tobsec/rusefi-hardware/lambda-x2/export/rev2/lambda-x2-rev2.pdf

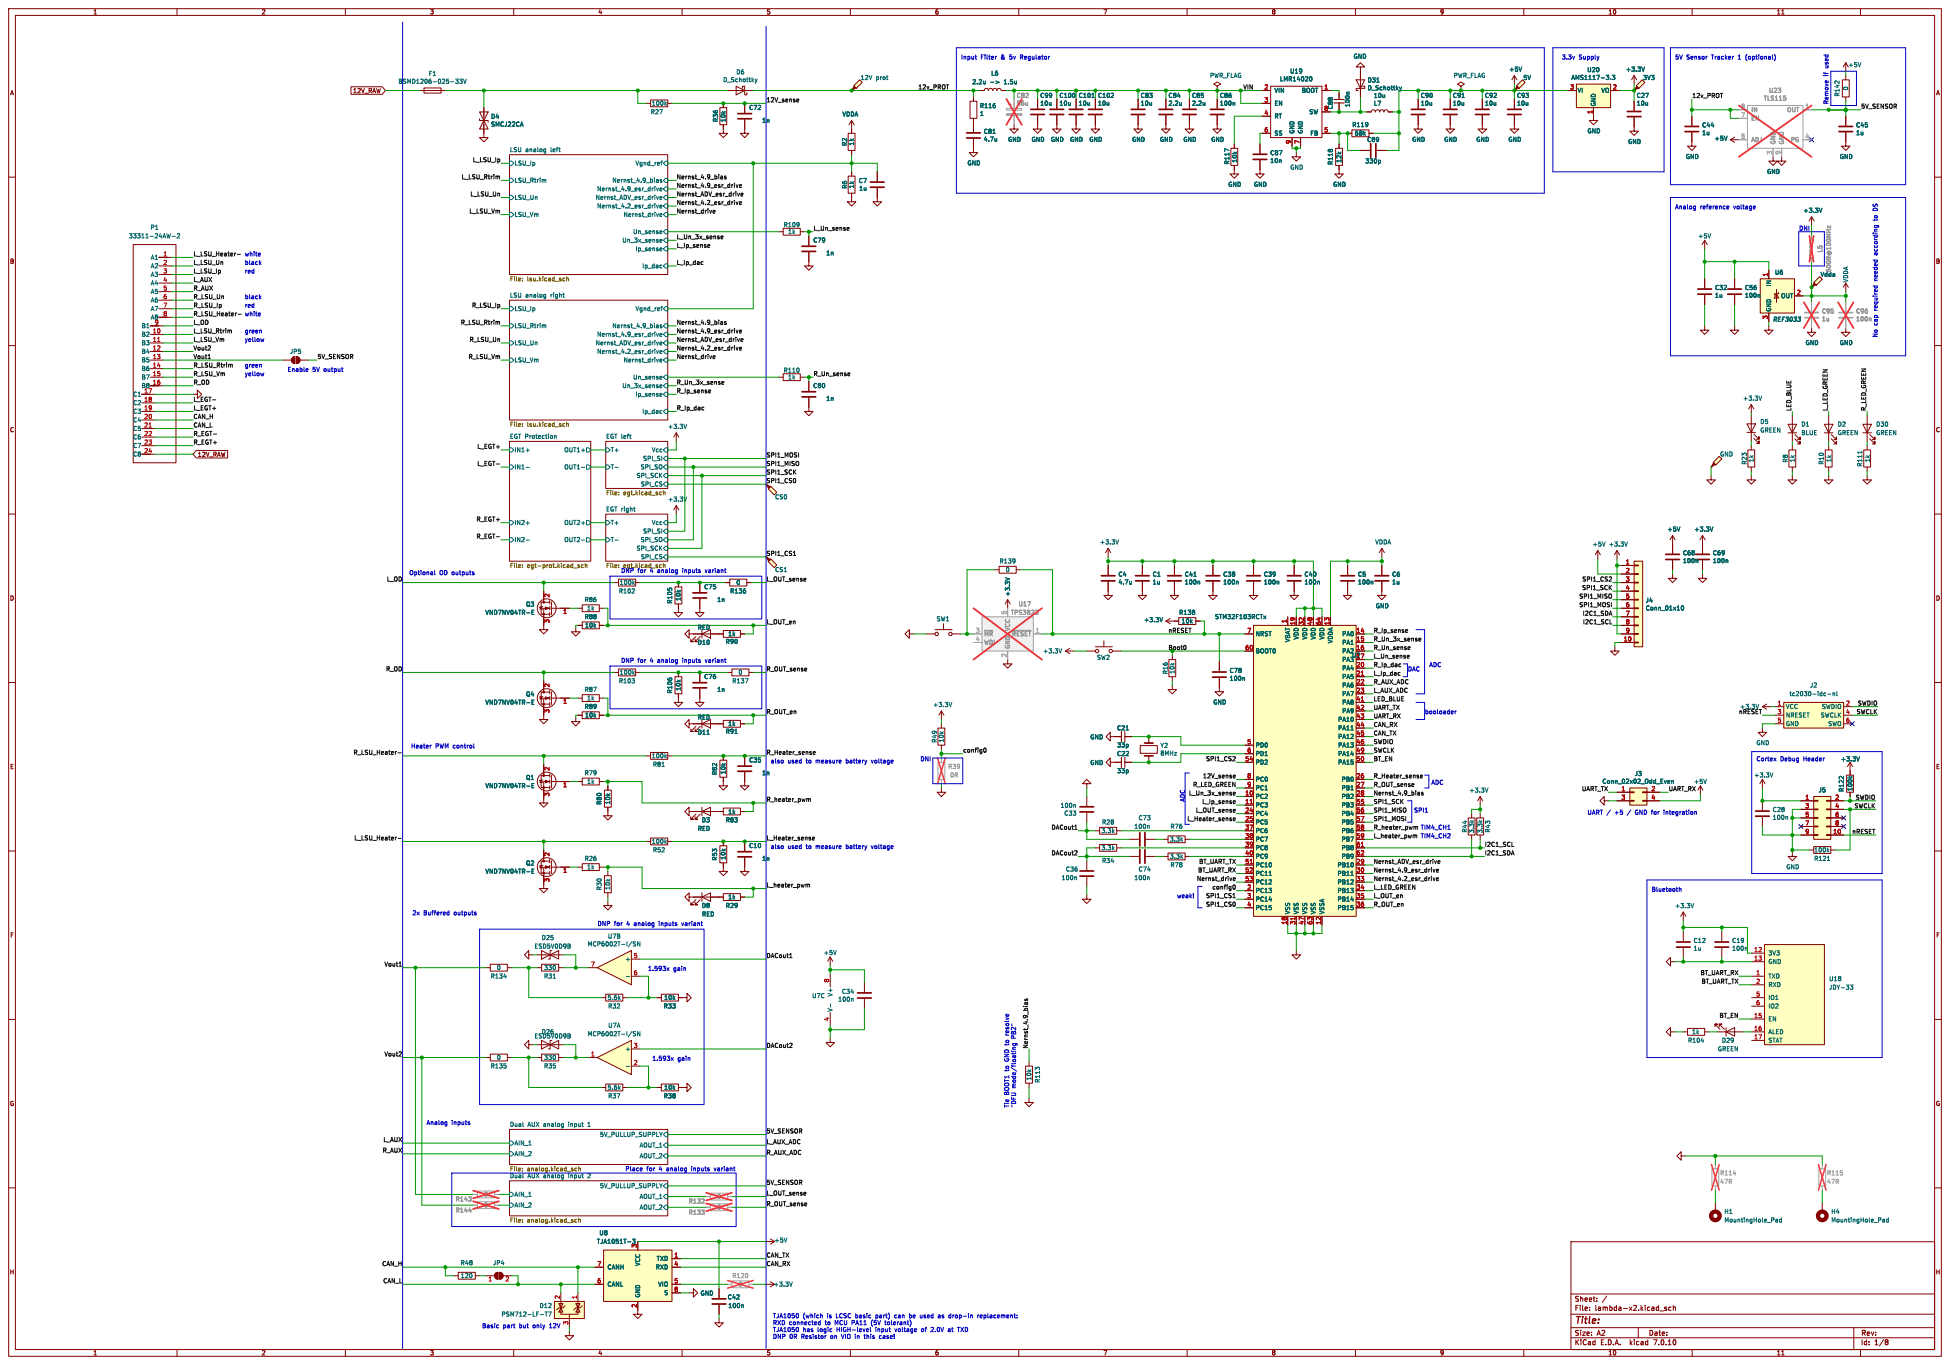
[picture p1: page 1]

LSU analog left File: lsu.kicad_sch

L_LSU_Vm
LSU analog right File: lsu.kicad_sch

SPI_CS
DNP for 4 analog inputs variant

DNP for 4 analog inputs variant Basic part but only 12V

5V_PULLUP_SUPPLY Dual AUX analog input 1 File: analog.kicad_sch

Place for 4 analog inputs variant

5V_PULLUP_SUPPLY Dual AUX analog input 2 File: analog.kicad_sch

3 RXD 4 VIO 5 CANL 6 CANH 7 S

DNP 0R Resistor on VIO in this case!

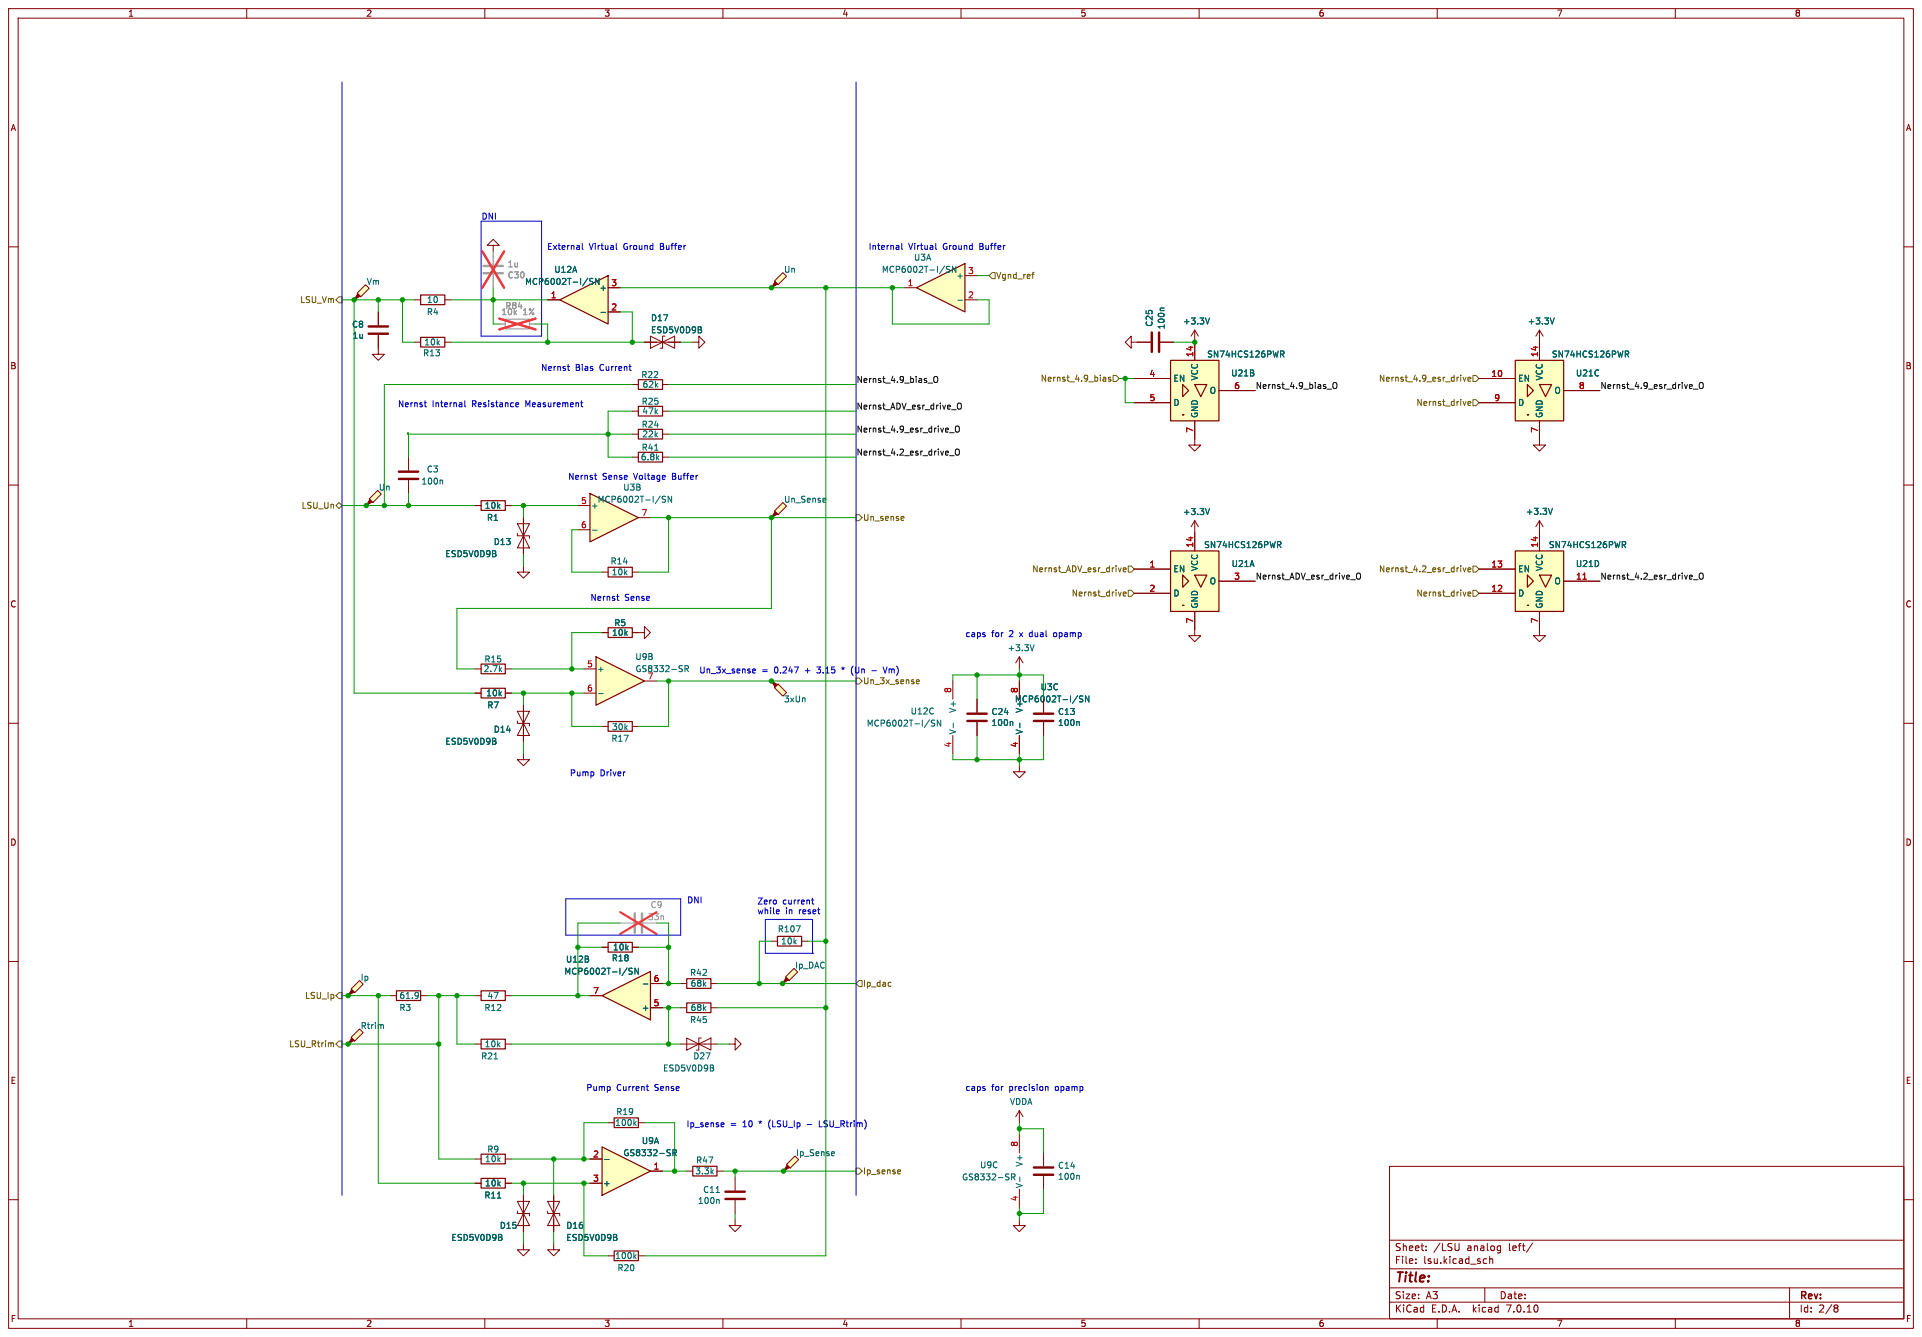
[picture p2: page 2]

Zero current while in reset

Id: 2/8 Title: File: lsu.kicad_sch Sheet: /LSU analog left/

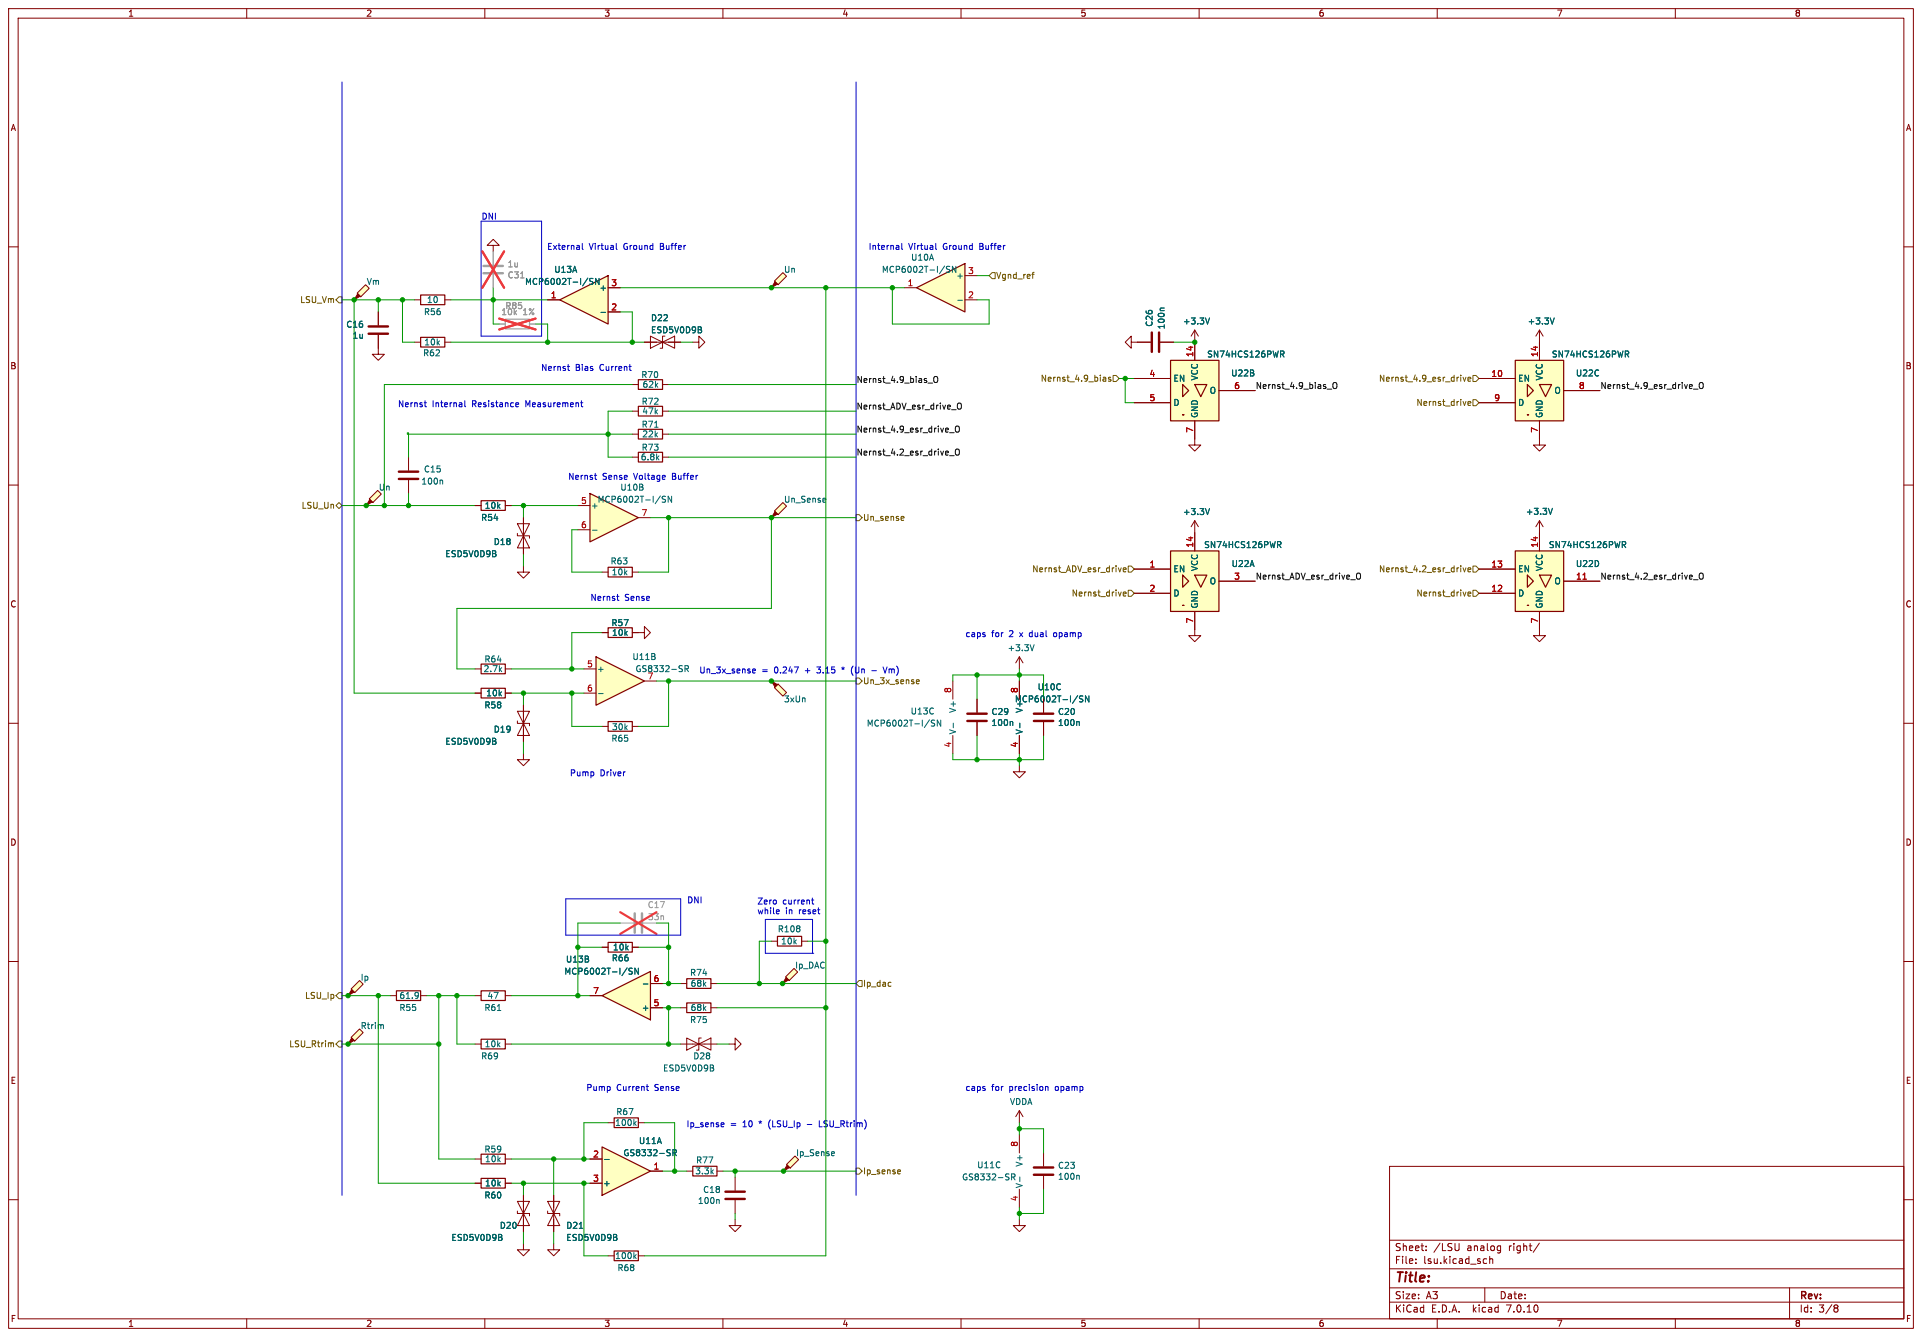
[picture p3: page 3]

Zero current while in reset

Id: 3/8 Title: File: lsu.kicad_sch Sheet: /LSU analog right/

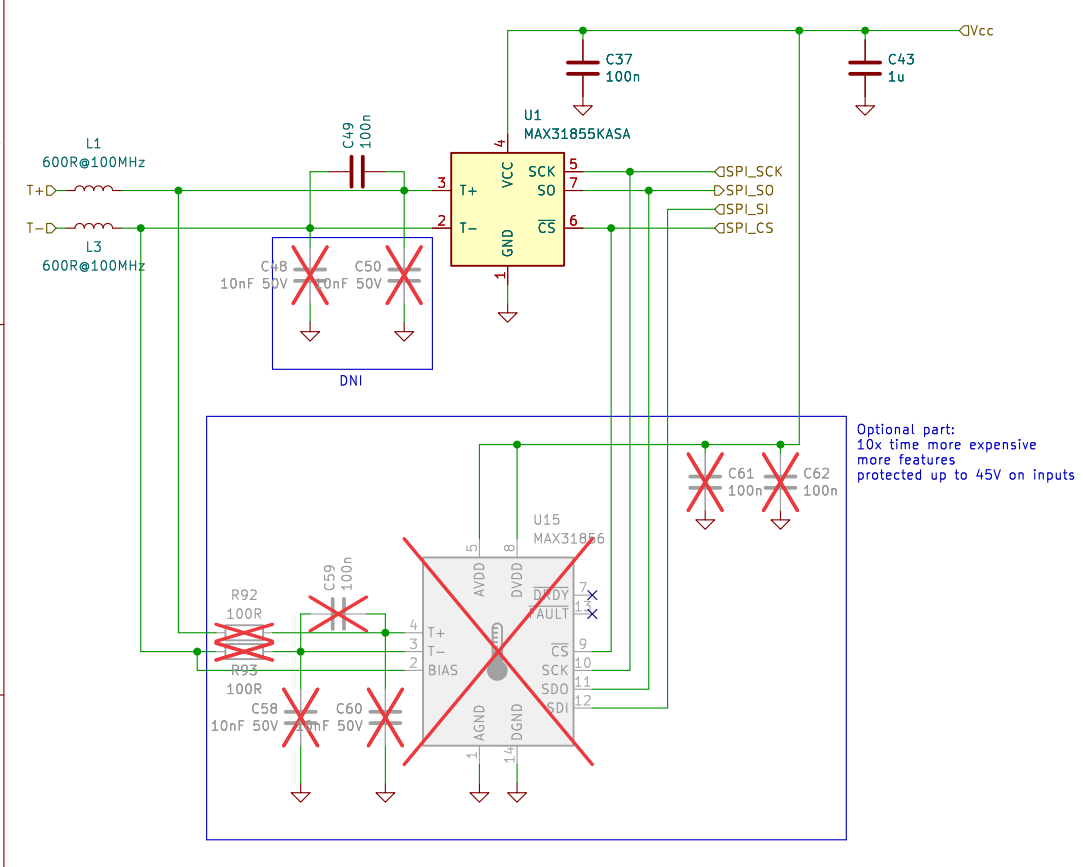
[picture p4: page 4]

1 SCK 10 SDO 11 SDI 12 ~{FAULT} 13 DGND 14 BIAS 2 T- 3 T+ 4 AVDD

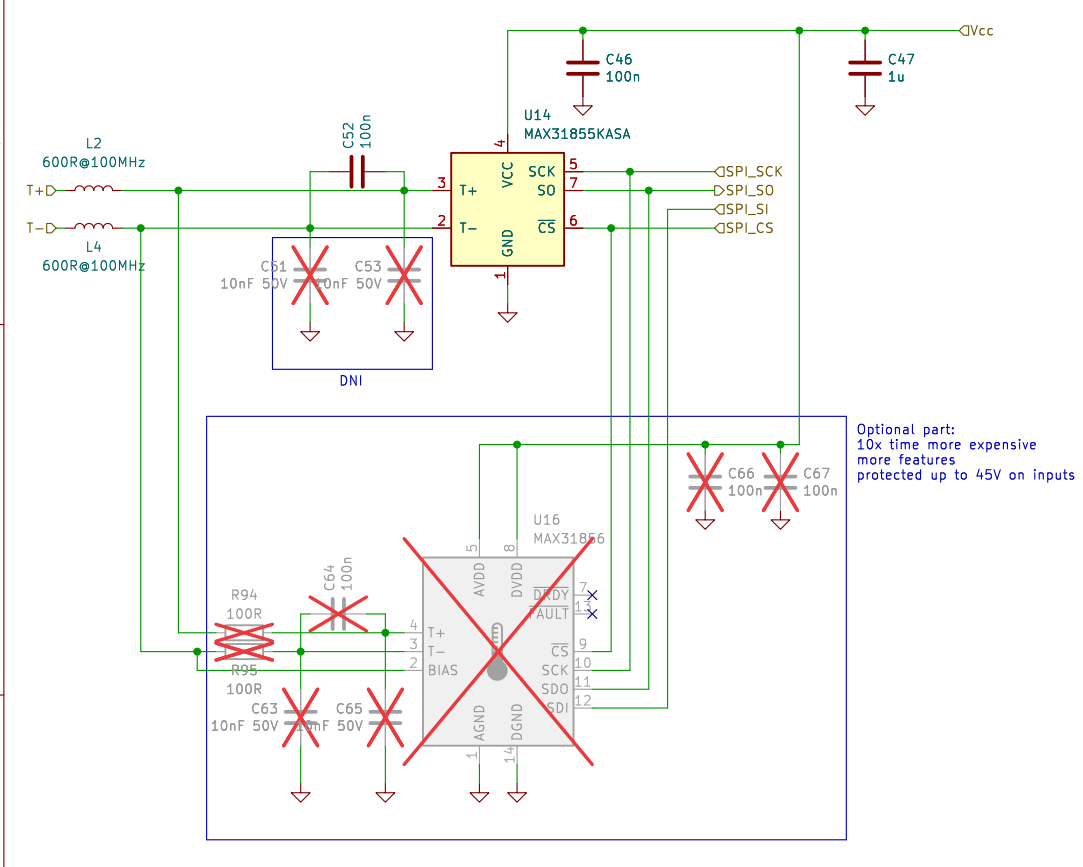
[picture p5: page 5]
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

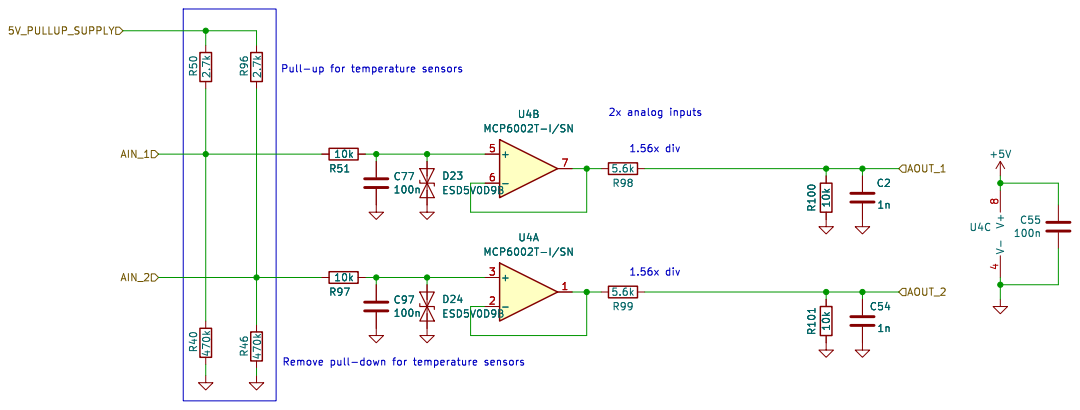
[picture p6: page 6]

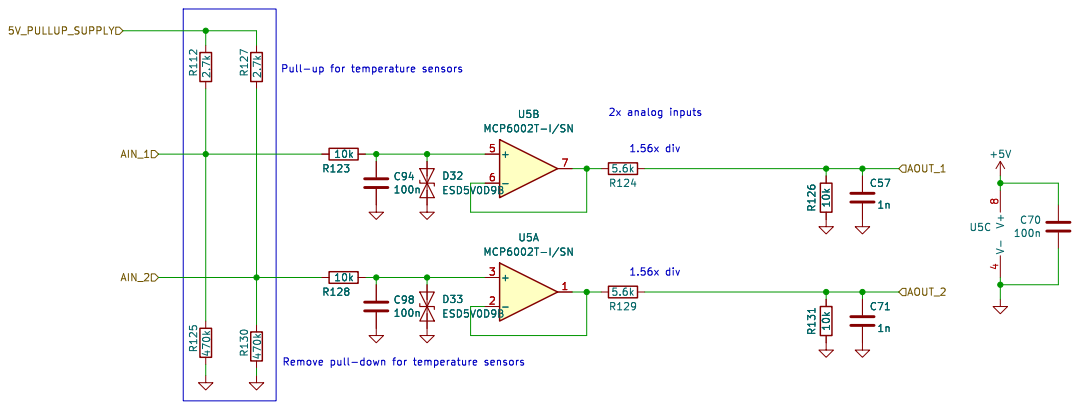
[picture p7: page 7]

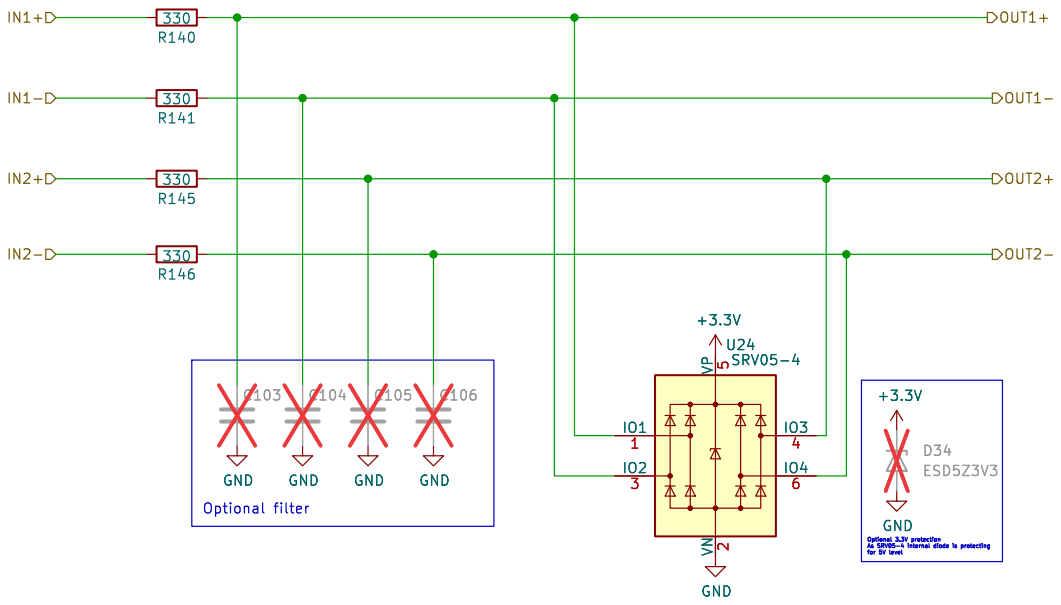
[picture p8: page 8]
