tobsec/rusefi-hardware/lambda-x2/analog.kicad_sch

## KiCad design lambda-x2/analog.kicad_sch (2024-02-21)

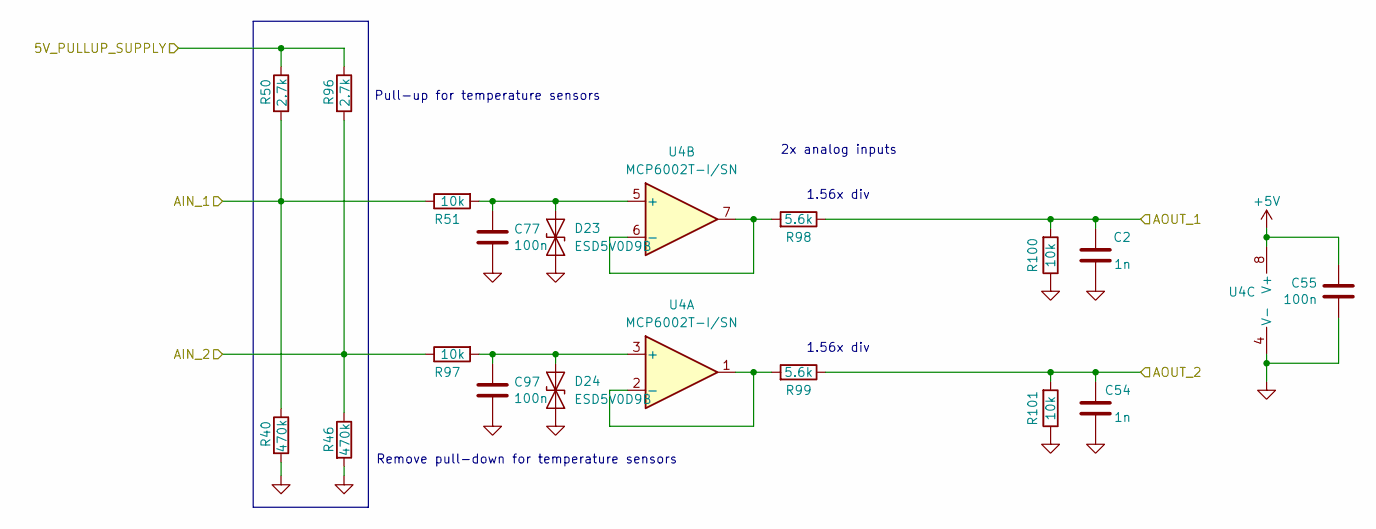
[picture p9: schematic analog.kicad_sch]

Parts:
C2, C54: 1n; C_0402_1005Metric; LCSC C1523
C55, C77, C97: 100n; C_0402_1005Metric; LCSC C1525
D23, D24: ESD5V0D9B; D_SOD-923; LCSC C484329
R40, R46: 470k; R_0402_1005Metric; LCSC C25790
R50, R96: 2.7k; R_0603_1608Metric; LCSC C13167
R51, R97, R100, R101: 10k; R_0402_1005Metric; LCSC C25744
R98, R99: 5.6k; R_0402_1005Metric; LCSC C25908
U4: MCP6002T-I/SN; SOIC-8_3.9x4.9mm_P1.27mm; LCSC C7377

Connections:
5V_PULLUP_SUPPLY: R50.1, R96.1
+5V: C55.1, U4.8 (V+)
AIN_1: R40.1, R50.2, R51.1
AIN_2: R46.1, R96.2, R97.1
AOUT_1: C2.1, R98.1, R100.2
AOUT_2: C54.1, R99.1, R101.2
GND: C2.2, C54.2, C55.2, R40.2, R46.2, R100.1, R101.1, U4.4 (V-)
unnamed: C77.1, D23.1 (A1), R51.2, U4.5 (+)
unnamed: C97.1, D24.1 (A1), R97.2, U4.3 (+)
unnamed: R98.2, U4.6 (-), U4.7
unnamed: R99.2, U4.1, U4.2 (-)
~: C77.2, C97.2, D23.2 (A2), D24.2 (A2)

Notes on the sheet:
Remove pull-down for temperature sensors
2x analog inputs
1.56x div
Pull-up for temperature sensors
