tobsec/rusefi-hardware/lambda-x2/egt-prot.kicad_sch

## KiCad design lambda-x2/egt-prot.kicad_sch (2024-02-21)

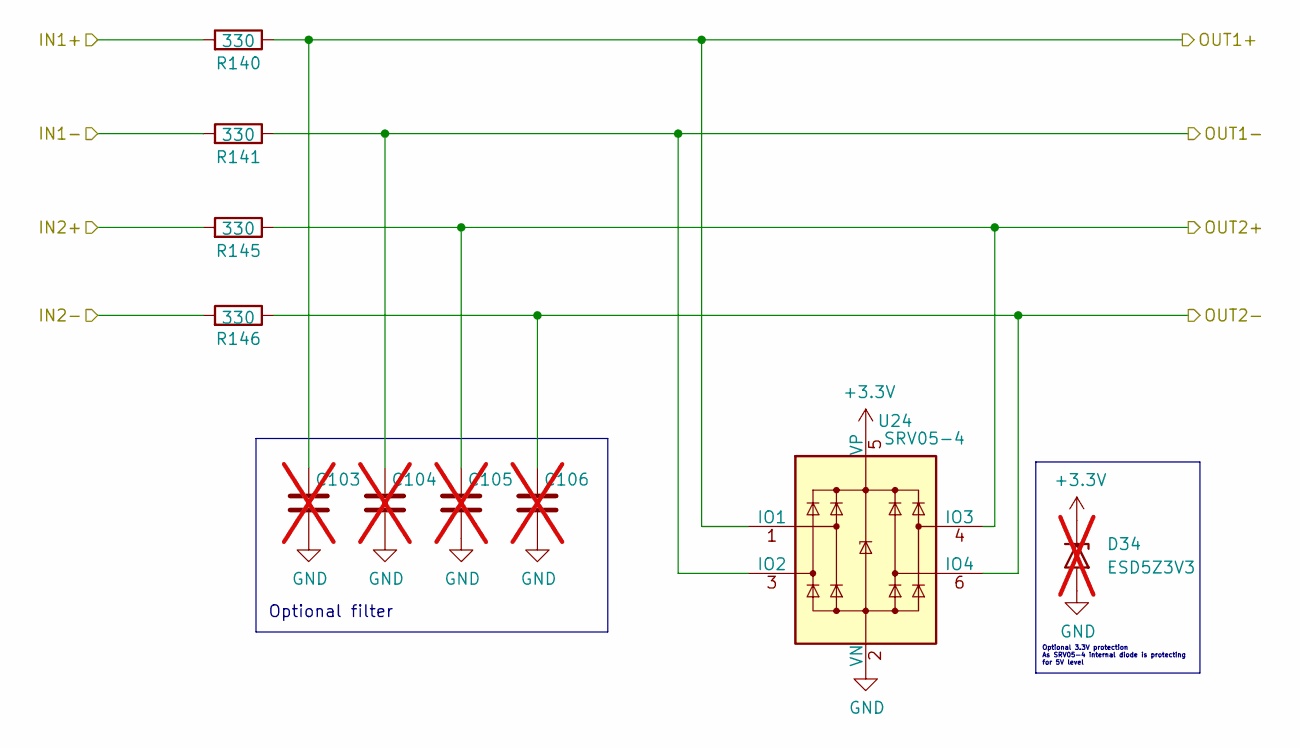
[picture p10: schematic egt-prot.kicad_sch]

Parts:
C103, C104, C105, C106: C_0402_1005Metric; not fitted
D34: ESD5Z3V3; D_SOD-523; LCSC C502545; not fitted
R140, R141, R145, R146: 330; R_0603_1608Metric; LCSC C23138
U24: SRV05-4; SOT-23-6; LCSC C85364

Connections:
+3.3V: D34.1 (A1), U24.5 (VP)
GND: C103.2, C104.2, C105.2, C106.2, D34.2 (A2), U24.2 (VN)
IN1+: R140.2
IN1-: R141.2
IN2+: R145.2
IN2-: R146.2
OUT1+: C103.1, R140.1, U24.1 (IO1)
OUT1-: C104.1, R141.1, U24.3 (IO2)
OUT2+: C105.1, R145.1, U24.4 (IO3)
OUT2-: C106.1, R146.1, U24.6 (IO4)

Notes on the sheet:
Optional 3.3V protection As SRV05-4 internal diode is protecting for 5V level
Optional filter
