tobsec/rusefi-hardware/lambda-x2/egt.kicad_sch

## KiCad design lambda-x2/egt.kicad_sch (2024-02-21)

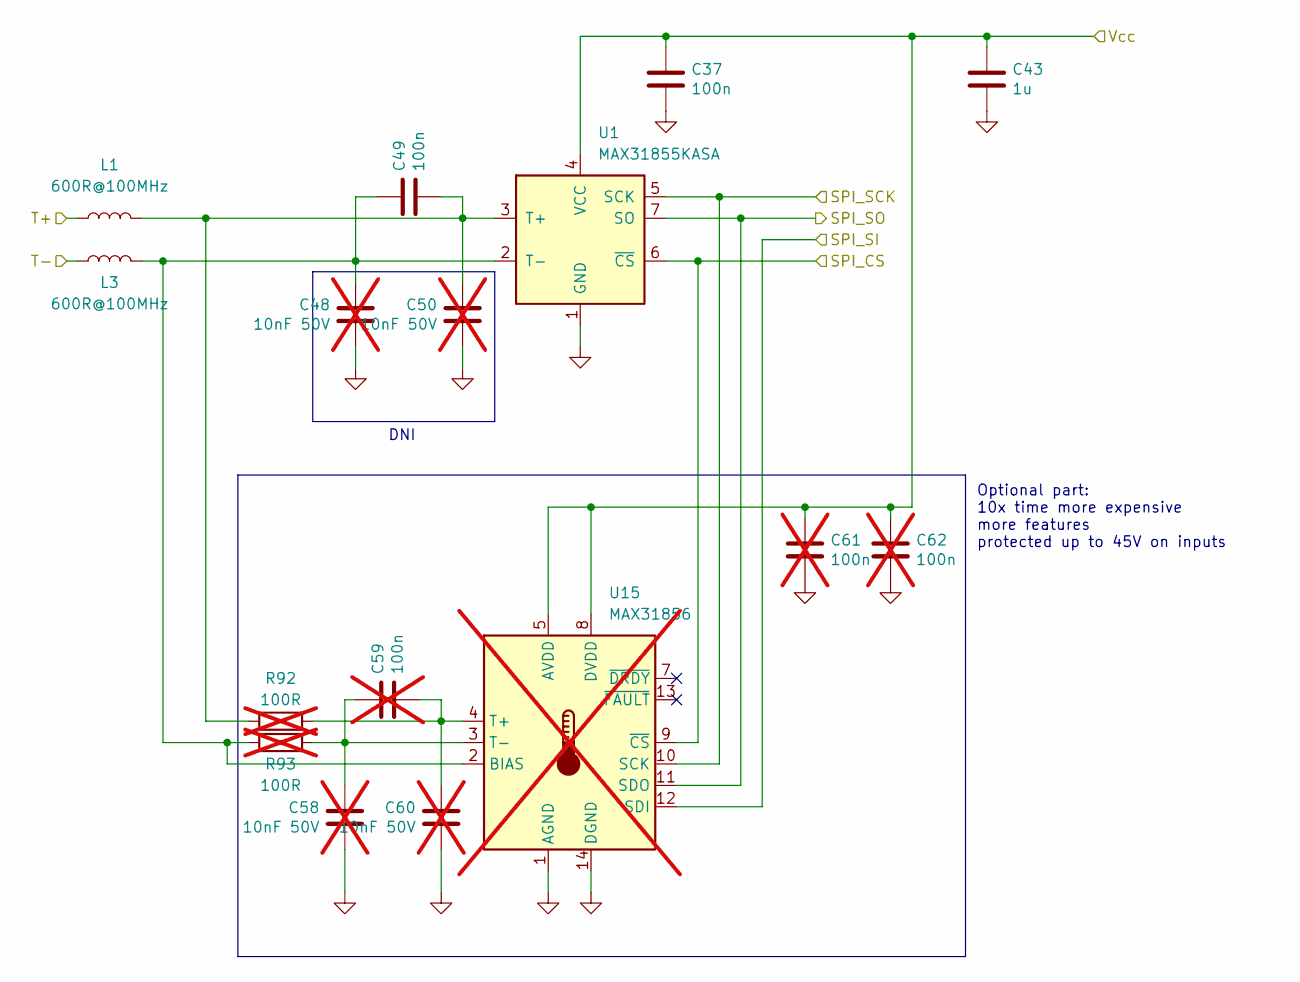
[picture p11: schematic egt.kicad_sch]

Parts:
C37, C49: 100n; C_0402_1005Metric; LCSC C1525
C43: 1u; C_0402_1005Metric; LCSC C52923
C48, C50, C58, C60: 10nF 50V; C_0402_1005Metric; LCSC C1524; not fitted
C59, C61, C62: 100n; C_0402_1005Metric; LCSC C1525; not fitted
L1, L3: 600R@100MHz; L_0603_1608Metric; LCSC C1002
R92, R93: 100R; R_0402_1005Metric; LCSC C25076; not fitted
U1: MAX31855KASA; SOIC-8_3.9x4.9mm_P1.27mm; LCSC C52028
U15: MAX31856; TSSOP-14_4.4x5mm_P0.65mm; LCSC C116632; not fitted

Connections:
GND: C37.2, C43.2, C48.2, C50.2, C58.2, C60.2, C61.2, C62.2, U1.1 (GND), U15.1 (AGND), U15.14 (DGND)
unnamed: C48.1, C49.1, L3.2, R93.1, U1.2 (T-), U15.2 (BIAS)
unnamed: C49.2, C50.1, L1.2, R92.1, U1.3 (T+)
unnamed: C58.1, C59.1, R93.2, U15.3 (T-)
unnamed: C59.2, C60.1, R92.2, U15.4 (T+)
SPI_CS: U1.6 (~CS), U15.9 (~CS)
SPI_SCK: U1.5 (SCK), U15.10 (SCK)
SPI_SI: U15.12 (SDI)
SPI_SO: U1.7 (SO), U15.11 (SDO)
T+: L1.1
T-: L3.1
Vcc: C37.1, C43.1, C61.1, C62.1, U1.4 (VCC), U15.5 (AVDD), U15.8 (DVDD)

Notes on the sheet:
DNI
Optional part: 10x time more expensive more features protected up to 45V on inputs
