tobsec/rusefi-hardware/lambda-x2/lambda-x2.kicad_sch

## KiCad design lambda-x2/lambda-x2.kicad_sch (2024-03-16)

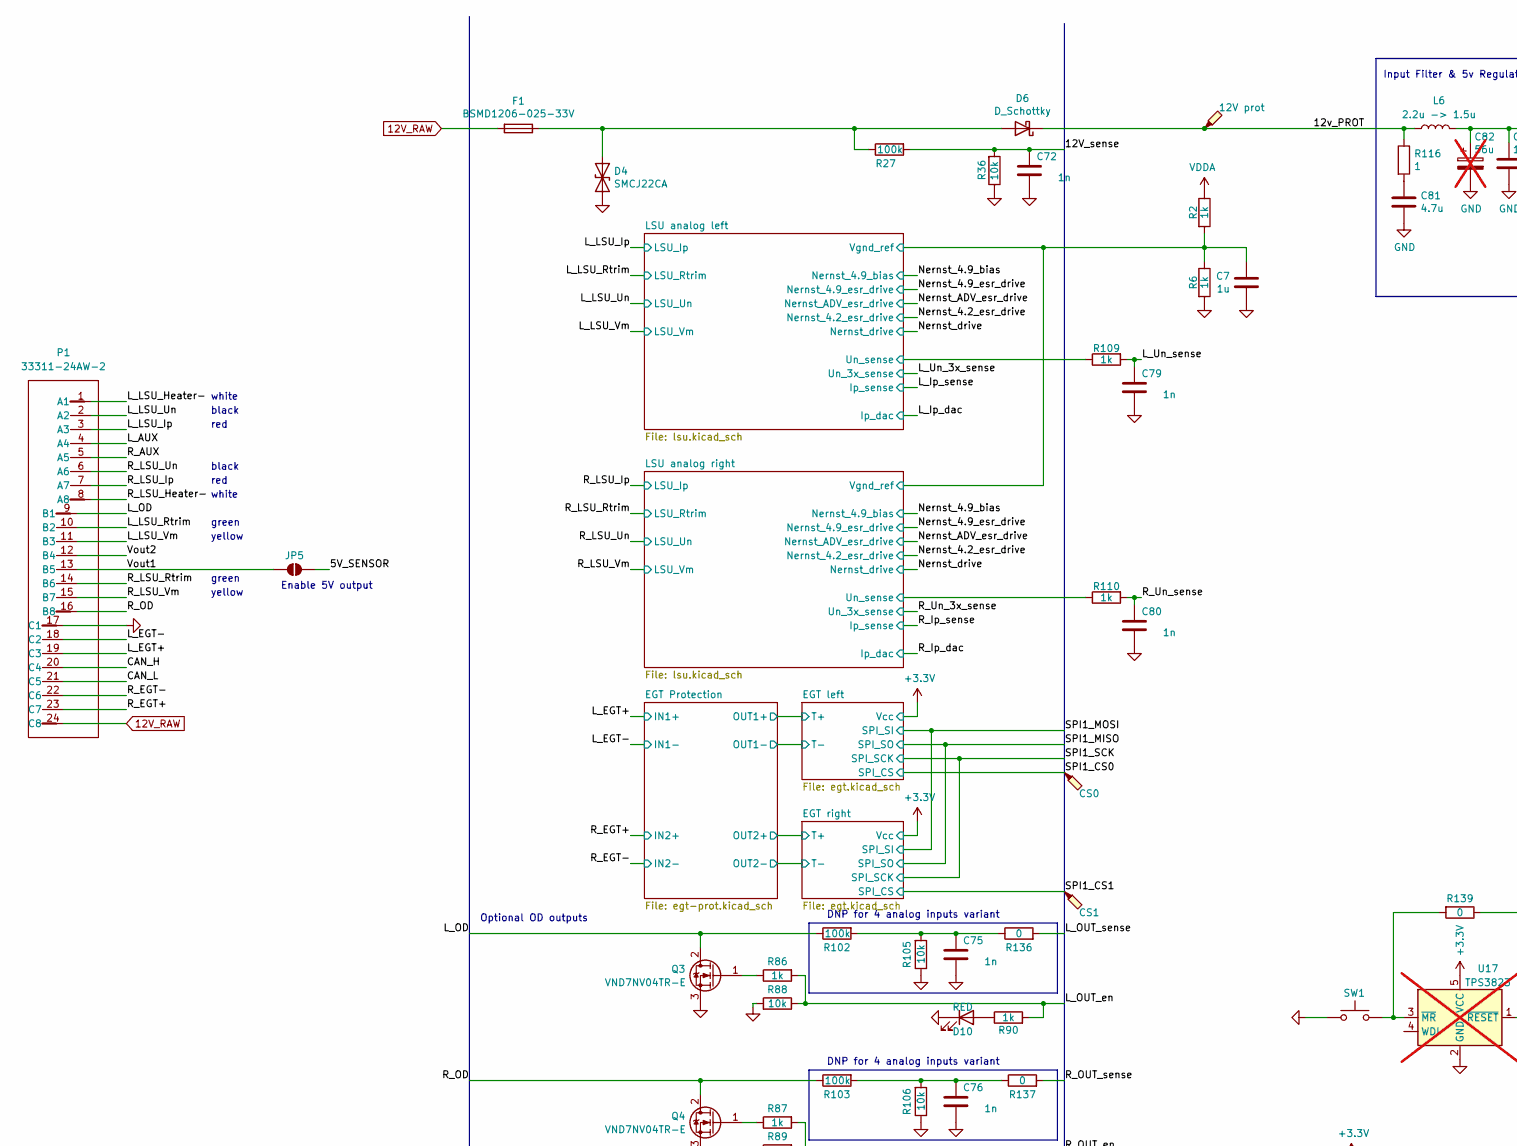
[picture p12: schematic lambda-x2.kicad_sch, part in row 1, column 1]

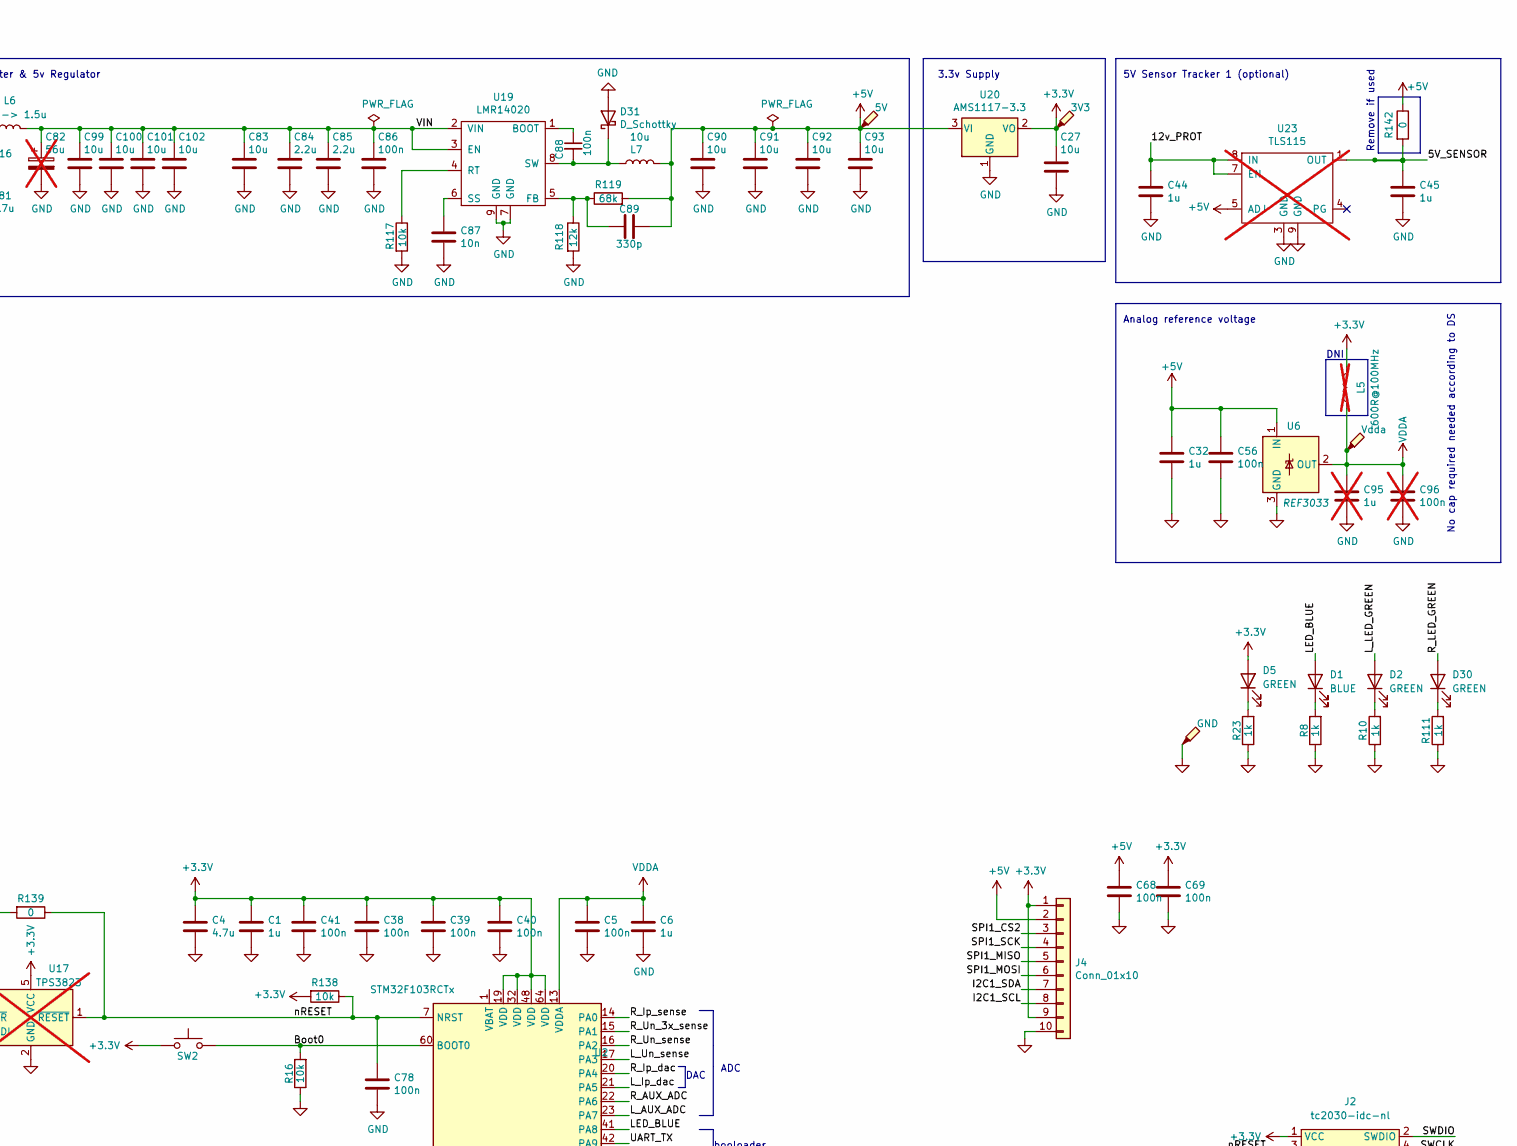
[picture p13: schematic lambda-x2.kicad_sch, part in row 1, column 2]

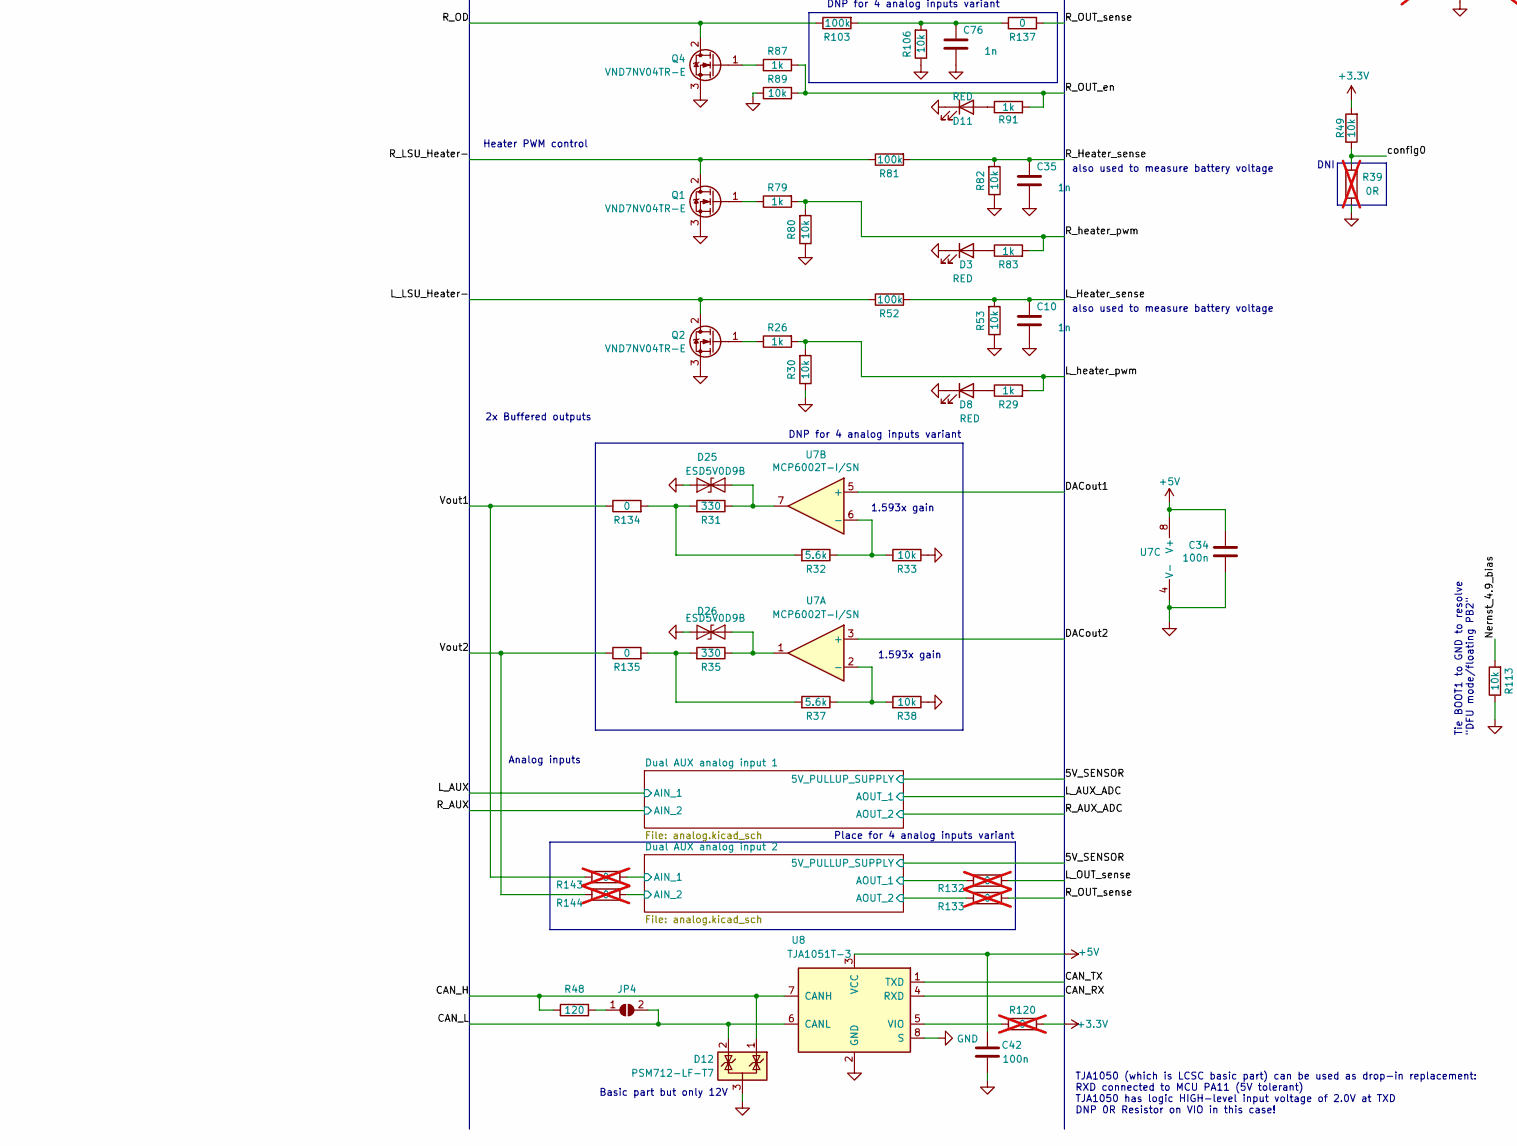
[picture p14: schematic lambda-x2.kicad_sch, part in row 2, column 1]

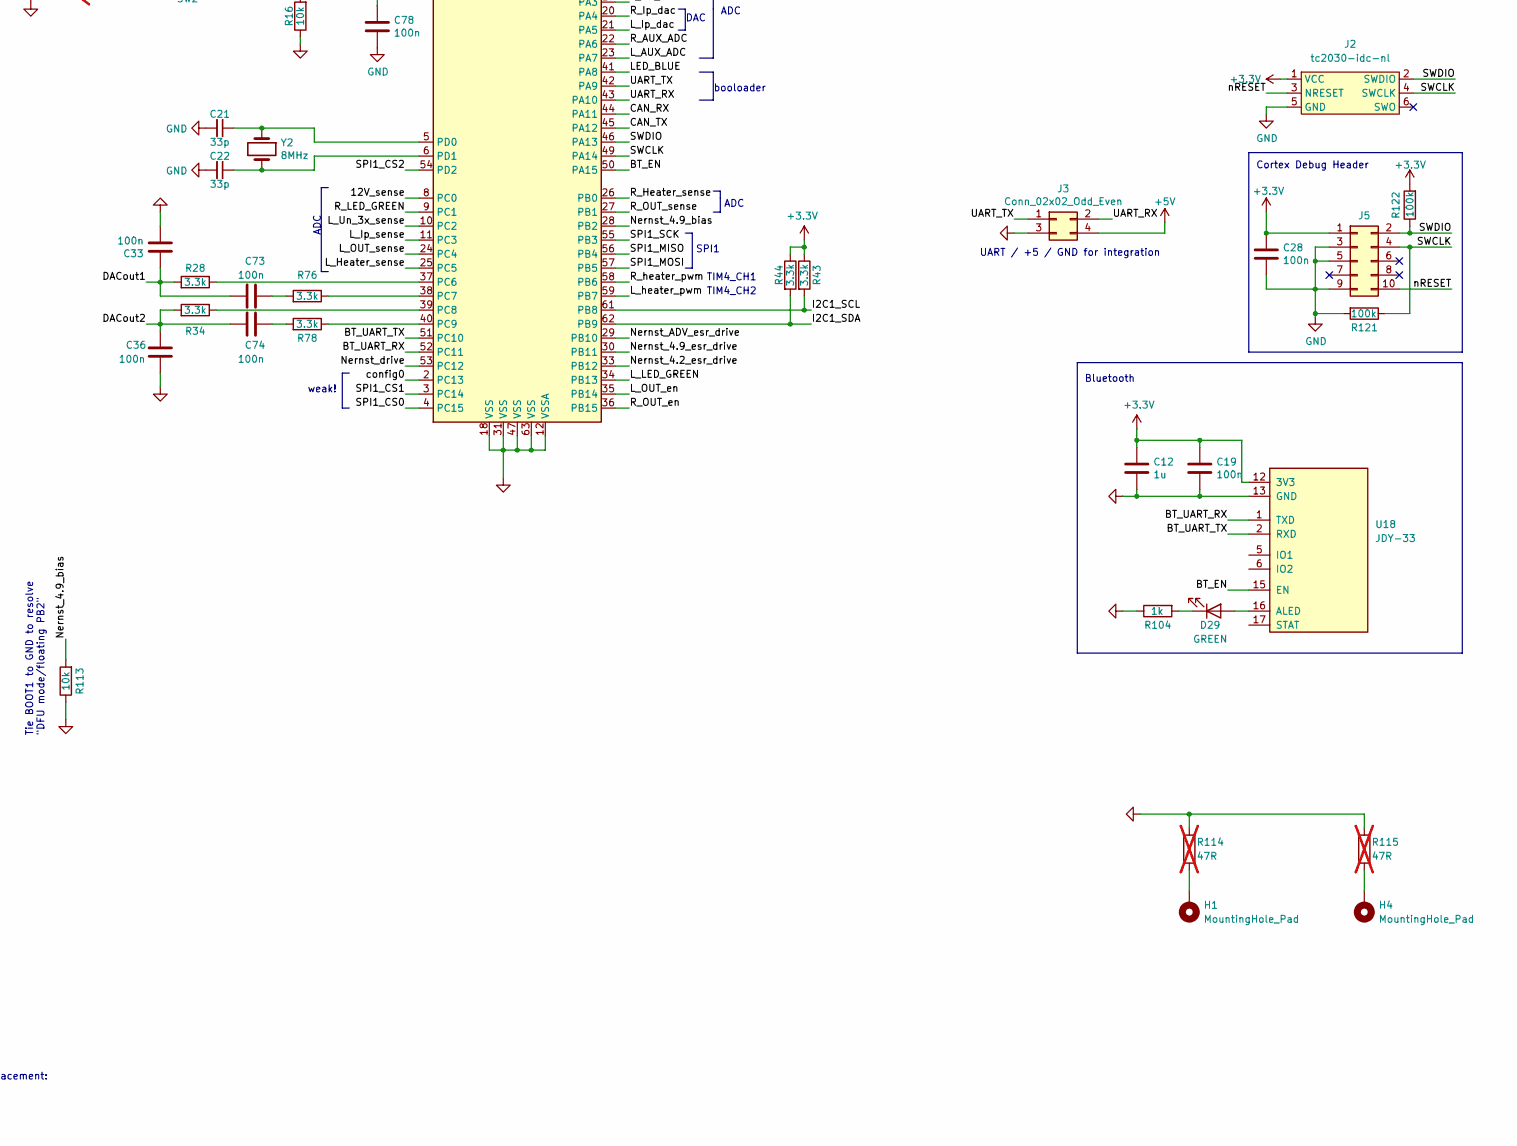
[picture p15: schematic lambda-x2.kicad_sch, part in row 2, column 2]

Parts:
C1, C6, C7, C12, C32: 1u; C_0402_1005Metric; LCSC C52923
C4: 4.7u; C_0402_1005Metric; LCSC C23733
C5, C19, C33, C34, C36, C38, C39, C40, C41, C42, C56, C68, C69, C73, C74, C78: 100n; C_0402_1005Metric; LCSC C1525
C10, C35, C72, C75, C76, C79, C80: 1n; C_0402_1005Metric; LCSC C1523
C21, C22: 33p; C_0402_1005Metric; LCSC C1562
C27, C83, C99, C100, C101, C102: 10u; C_0805_2012Metric; LCSC C440198
C28, C86, C88: 100n; C_0603_1608Metric; LCSC C14663
C44, C45: 1u; C_0603_1608Metric; LCSC C15849
C81: 4.7u; C_1206_3216Metric; LCSC C29823
C82: 56u; CP_Radial_D8.0mm_P3.50mm; LCSC C106564; not fitted
C84, C85: 2.2u; C_0805_2012Metric; LCSC C377773
C87: 10n; C_0603_1608Metric; LCSC C57112
C89: 330p; C_0402_1005Metric; LCSC C13533
C90, C91, C92, C93: 10u; C_1206_3216Metric; LCSC C13585
C95: 1u; C_0402_1005Metric; LCSC C52923; not fitted
C96: 100n; C_0402_1005Metric; LCSC C1525; not fitted
D1: BLUE; LED_0603_1608Metric; LCSC C72041
D2, D5, D29, D30: GREEN; LED_0603_1608Metric; LCSC C2986059
D3, D8, D10, D11: RED; LED_0603_1608Metric; LCSC C2286
D4: SMCJ22CA; D_SMC; LCSC C310038
D6, D31: D_Schottky; D_SMA; LCSC C14996
D12: PSM712-LF-T7; SOT-23; LCSC C32677
D25, D26: ESD5V0D9B; D_SOD-923; LCSC C484329
F1: BSMD1206-025-33V; Fuse_1206_3216Metric; LCSC C2977524
H1, H4: MountingHole_Pad; MountingHole_2.5mm_Pad_Via
J2: tc2030-idc-nl; LCSC N/A
J3: Conn_02x02_Odd_Even; PinHeader_2x02_P2.54mm_Vertical
J4: Conn_01x10; PinHeader_1x10_P2.54mm_Vertical
J5: Conn_02x05_Odd_Even; PinHeader_2x05_P2.54mm_Vertical; LCSC N/A
JP4, JP5: SolderJumper_2_Open; SolderJumper-2_P1.3mm_Open_TrianglePad1.0x1.5mm
L5: 600R@100MHz; L_0603_1608Metric; LCSC C1002; not fitted
L6: 2.2u -> 1.5u; L_1210_3225Metric; LCSC C394996
L7: 10u; MWSA0503; LCSC C408412
P1: 33311-24AW-2
Q1, Q2, Q3, Q4: VND7NV04TR-E; TO-252-3_TabPin2; LCSC C262999
R2, R6, R8, R10, R23, R26, R29, R79, R83, R86, R87, R90, R91, R104, R109, R110, R111: 1k; R_0402_1005Metric; LCSC C11702
R16, R30, R33, R36, R38, R49, R53, R80, R82, R88, R89, R105, R106, R113, R117, R138: 10k; R_0402_1005Metric; LCSC C25744
R27, R52, R81, R102, R103, R121, R122: 100k; R_0402_1005Metric; LCSC C25741
R28, R34, R43, R44, R76, R78: 3.3k; R_0402_1005Metric; LCSC C25890
R31, R35: 330; R_0603_1608Metric; LCSC C23138
R32, R37: 5.6k; R_0402_1005Metric; LCSC C25908
R39: 0R; R_0402_1005Metric; LCSC C325377; not fitted
R48: 120; R_0603_1608Metric; LCSC C22787
R114, R115: 47R; R_0603_1608Metric; LCSC C23182; not fitted
R116: 1; R_0603_1608Metric; LCSC C22936
R118: 12k; R_0402_1005Metric; LCSC C25752
R119: 68k; R_0402_1005Metric; LCSC C36871
R120, R132, R133, R143, R144: 0; R_0402_1005Metric; LCSC C17168; not fitted
R134, R135, R136, R137, R139, R142: 0; R_0402_1005Metric; LCSC C17168
SW1, SW2: SW_Push; SW_SPST_EVQQ2; LCSC C318884
TP7: 5V; TestPoint_Pad_D1.0mm
TP8: 3V3; TestPoint_Pad_D1.0mm
TP9: Vdda; TestPoint_Pad_D1.0mm
TP24: GND; TestPoint_Pad_D1.0mm
TP25: CS0; TestPoint_Pad_D1.0mm
TP26: CS1; TestPoint_Pad_D1.0mm
TP27: 12V prot; TestPoint_Pad_D1.0mm
U2: STM32F103RCTx; LQFP-64_10x10mm_P0.5mm; LCSC C8323
U6: REF3033; SOT-23; LCSC C36658
U7: MCP6002T-I/SN; SOIC-8_3.9x4.9mm_P1.27mm; LCSC C7377
U8: TJA1051T-3; SOIC-8_3.9x4.9mm_P1.27mm; LCSC C6952
U17: TPS3823; SOT-23-5; LCSC C7719; not fitted
U18: JDY-33; PARTREV v1.0; LCSC N/A
U19: LMR14020; SOIC-8-1EP_3.9x4.9mm_P1.27mm_EP2.29x3mm; LCSC C187824
U20: AMS1117-3.3; SOT-223-3_TabPin2; LCSC C6186
U23: TLS115; Infineon_PG-DSO-8-43; LCSC C3743696; not fitted
Y2: 8MHz; Crystal_SMD_5032-2Pin_5.0x3.2mm; LCSC C115962

Connections:
5V_SENSOR: C45.1, JP5.2 (B), R142.2, U23.1 (OUT)
12V_RAW: F1.2, P1.24 (C8)
12V_sense: C72.1, R27.2, R36.2, U2.8 (PC0)
12v_PROT: C44.1, D6.1 (K), L6.1, R116.1, TP27.1, U23.7 (EN), U23.8 (IN)
+3.3V: C1.1, C4.1, C12.1, C19.1, C27.1, C28.1, C38.1, C39.1, C40.1, C41.1, C69.1, D5.2 (A), J2.1 (VCC), J4.1, J4.9, J5.1, L5.2, R43.1, R44.1, R49.2, R120.2, R122.2, R138.2, SW2.1, TP8.1, U2.19 (VDD), U2.32 (VDD), U2.48 (VDD), U2.64 (VDD), U17.5 (VCC), U18.12 (3V3), U20.2 (VO)
+5V: C32.1, C34.1, C42.1, C56.1, C68.1, C89.1, C90.1, C91.1, C92.1, C93.1, J3.4, J4.2, L7.2, R119.2, R142.1, TP7.1, U6.1 (IN), U7.8 (V+), U8.3 (VCC), U20.3 (VI), U23.5 (ADJ)
AIN_1: R143.2
AIN_2: R144.2
AOUT_1: R132.1
AOUT_2: R133.1
BT_EN: U2.50 (PA15), U18.15 (EN)
BT_UART_RX: U2.52 (PC11), U18.1 (TXD)
BT_UART_TX: U2.51 (PC10), U18.2 (RXD)
Boot0: R16.2, SW2.2, U2.60 (BOOT0)
CAN_H: D12.1 (K), P1.20 (C4), R48.1, U8.7 (CANH)
CAN_L: D12.2 (K), JP4.2 (B), P1.21 (C5), U8.6 (CANL)
CAN_RX: U2.44 (PA11), U8.4 (RXD)
CAN_TX: U2.45 (PA12), U8.1 (TXD)
DACout1: C33.1, C73.2, R28.2, U7.5 (+)
DACout2: C36.1, C74.2, R34.2, U7.3 (+)
GND: C1.2, C4.2, C5.2, C6.2, C7.2, C10.2, C12.2, C19.2, C21.2, C22.2, C27.2, C28.2, C32.2, C33.2, C34.2, C35.2, C36.2, C38.2, C39.2, C40.2, C41.2, C42.2, C44.2, C45.2, C56.2, C68.2, C69.2, C72.2, C75.2, C76.2, C78.2, C79.2, C80.2, C81.2, C82.2, C83.2, C84.2, C85.2, C86.2, C87.2, C90.2, C91.2, C92.2, C93.2, C95.2, C96.2, C99.2, C100.2, C101.2, C102.2, D3.1 (K), D4.2 (A2), D8.1 (K), D10.1 (K), D11.1 (K), D12.3 (A), D31.2 (A), J2.5 (GND), J3.3, J4.10, J5.3, J5.5, J5.9, P1.17 (C1), Q1.3 (S), Q2.3 (S), Q3.3 (S), Q4.3 (S), R6.2, R8.1, R10.1, R16.1, R23.1, R30.1, R33.1, R36.1, R38.1, R39.2, R53.1, R80.1, R82.1, R88.2, R89.1, R104.1, R105.1, R106.1, R111.1, R113.1, R114.2, R115.2, R117.2, R118.2, R121.2, SW1.1, TP24.1, U2.12 (VSSA), U2.18 (VSS), U2.31 (VSS), U2.47 (VSS), U2.63 (VSS), U6.3 (GND), U7.4 (V-), U8.2 (GND), U8.8 (S), U17.2 (GND), U18.13 (GND), U19.7 (GND), U19.9 (GND), U20.1 (GND), U23.3 (GND), U23.9 (GND)
I2C1_SCL: J4.8, R43.2, U2.61 (PB8)
I2C1_SDA: J4.7, R44.2, U2.62 (PB9)
LED_BLUE: D1.2 (A), U2.41 (PA8)
L_AUX: P1.4 (A4)
L_AUX_ADC: U2.23 (PA7)
L_EGT+: P1.19 (C3)
L_EGT-: P1.18 (C2)
L_Heater_sense: C10.1, R52.2, R53.2, U2.25 (PC5)
L_Ip_dac: U2.21 (PA5)
L_Ip_sense: U2.11 (PC3)
L_LED_GREEN: D2.2 (A), U2.34 (PB13)
L_LSU_Heater-: P1.1 (A1), Q2.2 (D), R52.1
L_LSU_Ip: P1.3 (A3)
L_LSU_Rtrim: P1.10 (B2)
L_LSU_Un: P1.2 (A2)
L_LSU_Vm: P1.11 (B3)
L_OD: P1.9 (B1), Q3.2 (D), R102.1
L_OUT_en: R86.2, R88.1, R90.2, U2.35 (PB14)
L_OUT_sense: R132.2, R136.2, U2.24 (PC4)
L_Un_3x_sense: U2.10 (PC2)
L_Un_sense: C79.1, R109.2, U2.17 (PA3)
L_heater_pwm: R26.2, R29.2, R30.2, U2.59 (PB7)
Nernst_4.2_esr_drive: U2.33 (PB12)
Nernst_4.9_bias: R113.2, U2.28 (PB2)
Nernst_4.9_esr_drive: U2.30 (PB11)
Nernst_ADV_esr_drive: U2.29 (PB10)
Nernst_drive: U2.53 (PC12)
unnamed: C21.1, U2.5 (PD0), Y2.1
unnamed: C22.1, U2.6 (PD1), Y2.2
unnamed: C73.1, R76.2
unnamed: C74.1, R78.2
unnamed: C75.1, R102.2, R105.2, R136.1
unnamed: C76.1, R103.2, R106.2, R137.1
unnamed: C81.1, R116.2
unnamed: C87.1, U19.6 (SS)
unnamed: C88.1, U19.1 (BOOT)
unnamed: C88.2, D31.1 (K), L7.1, U19.8 (SW)
unnamed: C89.2, R118.1, R119.1, U19.5 (FB)
unnamed: D1.1 (K), R8.2
unnamed: D2.1 (K), R10.2
unnamed: D3.2 (A), R83.1
unnamed: D4.1 (A1), D6.2 (A), F1.1, R27.1
unnamed: D5.1 (K), R23.2
unnamed: D8.2 (A), R29.1
unnamed: D10.2 (A), R90.1
unnamed: D11.2 (A), R91.1
unnamed: D25.1 (A1), R31.1, U7.7
unnamed: D26.1 (A1), R35.1, U7.1
unnamed: D29.1 (K), R104.2
unnamed: D29.2 (A), U18.16 (ALED)
unnamed: D30.1 (K), R111.2
unnamed: H1.1, R114.1
unnamed: H4.1, R115.1
unnamed: JP4.1 (A), R48.2
unnamed: Q1.1 (G), R79.1
unnamed: Q2.1 (G), R26.1
unnamed: Q3.1 (G), R86.1
unnamed: Q4.1 (G), R87.1
unnamed: R28.1, U2.37 (PC6)
unnamed: R32.1, R33.2, U7.6 (-)
unnamed: R34.1, U2.39 (PC8)
unnamed: R37.1, R38.2, U7.2 (-)
unnamed: R76.1, U2.38 (PC7)
unnamed: R78.1, U2.40 (PC9)
unnamed: R117.1, U19.4 (RT)
unnamed: R120.1, U8.5 (VIO)
unnamed: R31.2, R32.2, R134.2
unnamed: R35.2, R37.2, R135.2
unnamed: R139.2, SW1.2, U17.3 (~MR)
R_AUX: P1.5 (A5)
R_AUX_ADC: U2.22 (PA6)
R_EGT+: P1.23 (C7)
R_EGT-: P1.22 (C6)
R_Heater_sense: C35.1, R81.2, R82.2, U2.26 (PB0)
R_Ip_dac: U2.20 (PA4)
R_Ip_sense: U2.14 (PA0)
R_LED_GREEN: D30.2 (A), U2.9 (PC1)
R_LSU_Heater-: P1.8 (A8), Q1.2 (D), R81.1
R_LSU_Ip: P1.7 (A7)
R_LSU_Rtrim: P1.14 (B6)
R_LSU_Un: P1.6 (A6)
R_LSU_Vm: P1.15 (B7)
R_OD: P1.16 (B8), Q4.2 (D), R103.1
R_OUT_en: R87.2, R89.2, R91.2, U2.36 (PB15)
R_OUT_sense: R133.2, R137.2, U2.27 (PB1)
R_Un_3x_sense: U2.15 (PA1)
R_Un_sense: C80.1, R110.2, U2.16 (PA2)
R_heater_pwm: R79.2, R80.2, R83.2, U2.58 (PB6)
SPI1_CS0: TP25.1, U2.4 (PC15)
SPI1_CS1: TP26.1, U2.3 (PC14)
SPI1_CS2: J4.3, U2.54 (PD2)
SPI1_MISO: J4.5, U2.56 (PB4)
SPI1_MOSI: J4.6, U2.57 (PB5)
SPI1_SCK: J4.4, U2.55 (PB3)
SWCLK: J2.4 (SWCLK), J5.4, R121.1, U2.49 (PA14)
SWDIO: J2.2 (SWDIO), J5.2, R122.1, U2.46 (PA13)
UART_RX: J3.2, U2.43 (PA10)
UART_TX: J3.1, U2.42 (PA9)
Un_sense: R109.1, R110.1
VDDA: C5.1, C6.1, C95.1, C96.1, L5.1, R2.1, TP9.1, U2.13 (VDDA), U6.2 (OUT)
VIN: C82.1, C83.1, C84.1, C85.1, C86.1, C99.1, C100.1, C101.1, C102.1, L6.2, U19.2 (VIN), U19.3 (EN)
Vgnd_ref: C7.1, R2.2, R6.1
Vout1: JP5.1 (A), P1.13 (B5), R134.1, R143.1
Vout2: P1.12 (B4), R135.1, R144.1
config0: R39.1, R49.1, U2.2 (PC13)
nRESET: C78.1, J2.3 (NRESET), J5.10, R138.1, R139.1, U2.7 (NRST), U17.1 (~RESET)
~: D25.2 (A2), D26.2 (A2)

Notes on the sheet:
yellow
No cap required needed according to DS
red
weak!
DNP for 4 analog inputs variant
DNI
Input Filter & 5v Regulator
SPI1
1.593x gain
Basic part but only 12V
Analog inputs
3.3v Supply
booloader
Place for 4 analog inputs variant
Cortex Debug Header
Bluetooth
white
DAC
black
green
Heater PWM control
2x Buffered outputs
ADC
Remove if used
5V Sensor Tracker 1 (optional)
TJA1050 (which is LCSC basic part) can be used as drop-in replacement: RXD connected to MCU PA11 (5V tolerant) TJA1050 has logic HIGH-level input voltage of 2.0V at TXD DNP 0R Resistor on VIO in this case!
TIM4_CH2
Optional OD outputs
Enable 5V output
also used to measure battery voltage
Analog reference voltage
UART / +5 / GND for integration
Tie BOOT1 to GND to resolve "DFU mode/floating PB2"
TIM4_CH1
