tobsec/rusefi-hardware/lambda-x2/lsu.kicad_sch

## KiCad design lambda-x2/lsu.kicad_sch (2024-02-21)

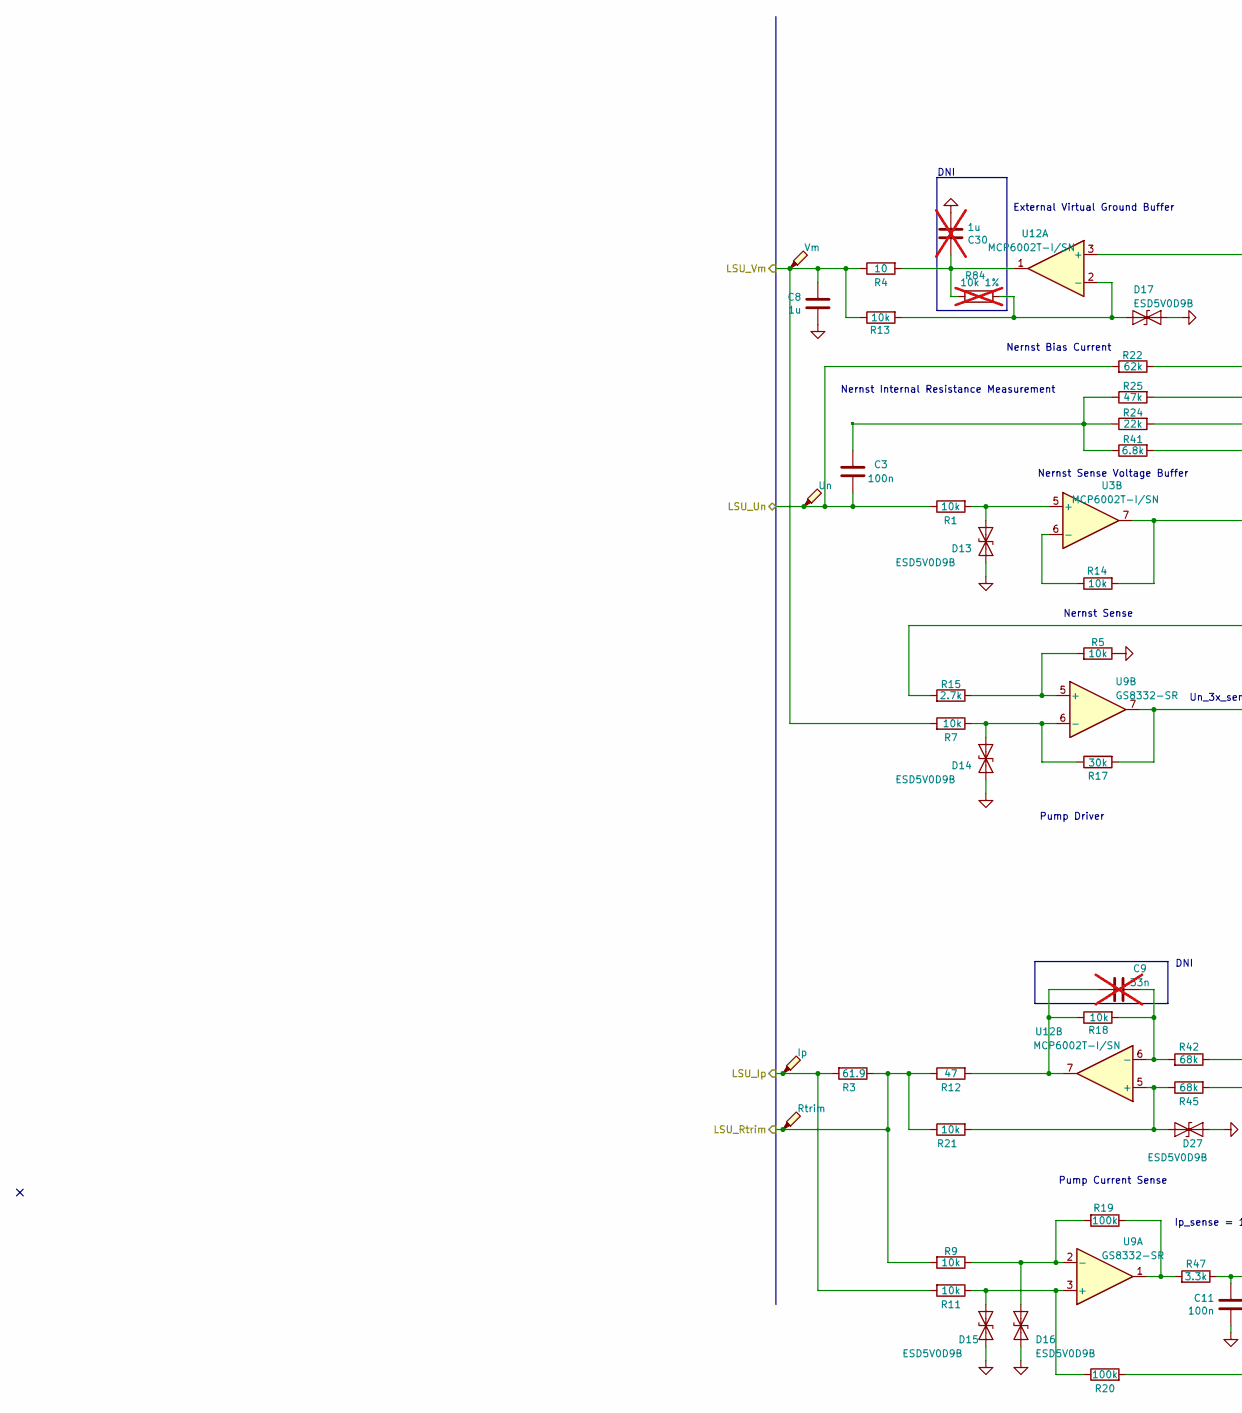
[picture p16: schematic lsu.kicad_sch, part in row 1, column 1]

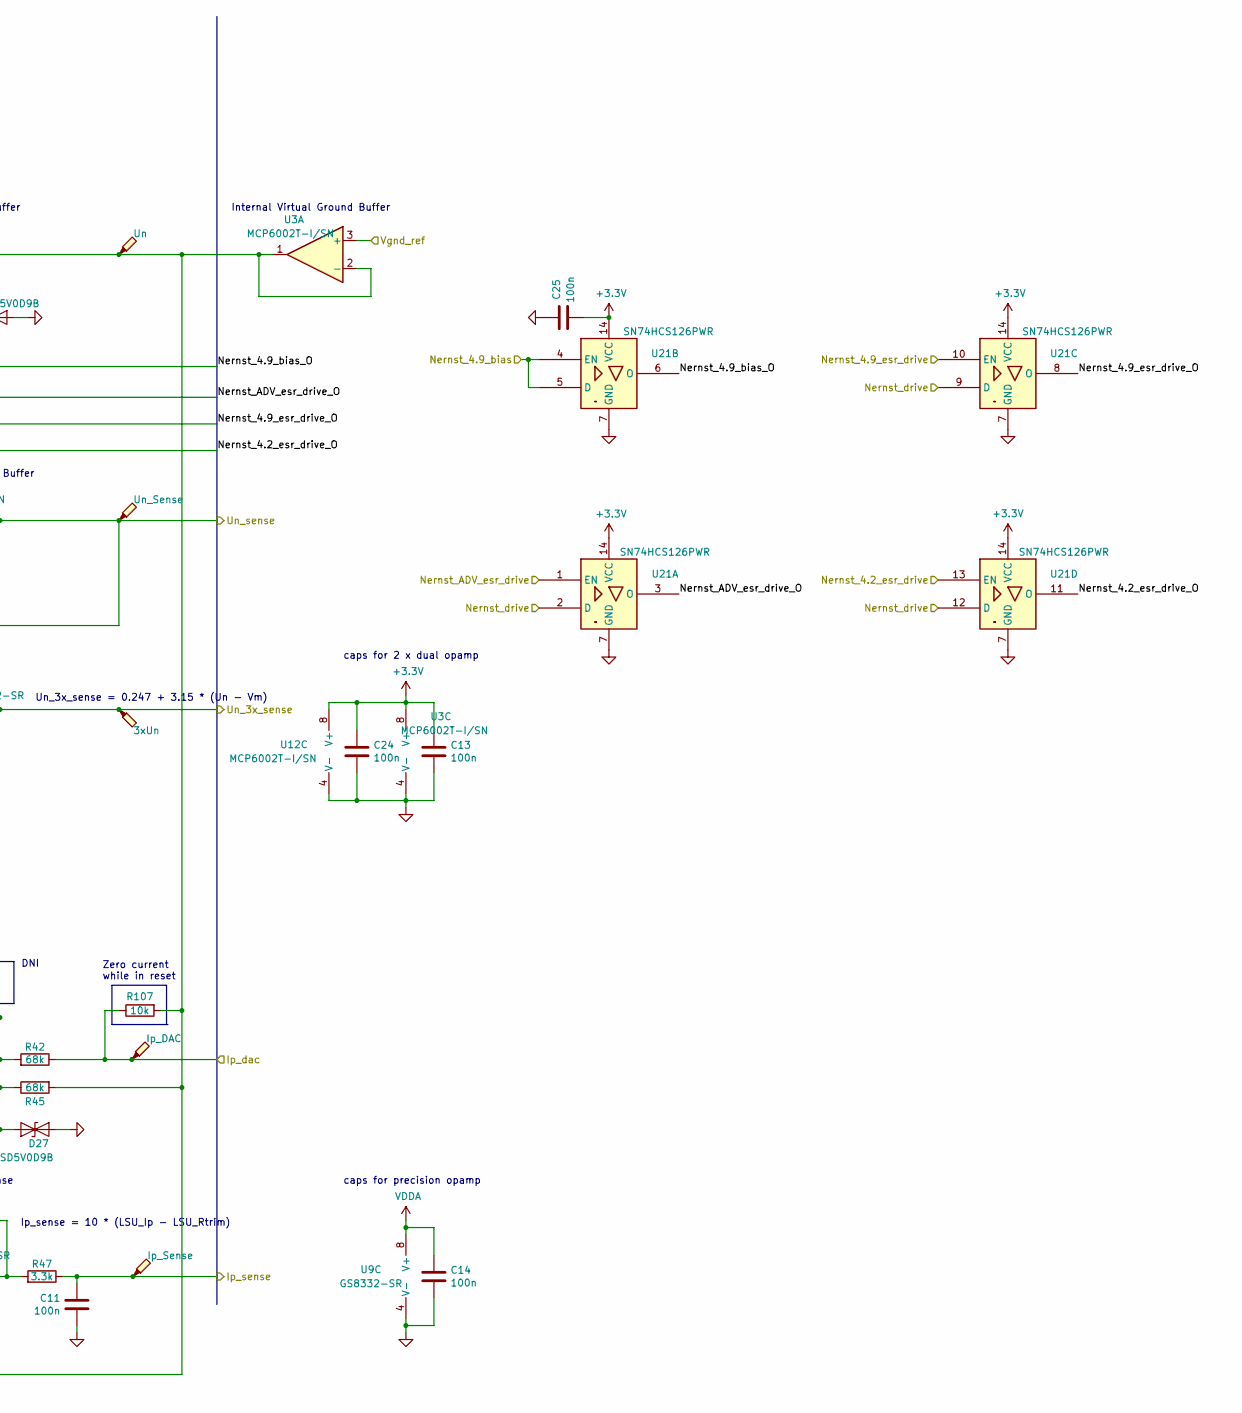
[picture p17: schematic lsu.kicad_sch, part in row 1, column 2]

Parts:
C3, C11, C13, C14, C24, C25: 100n; C_0402_1005Metric; LCSC C1525
C8: 1u; C_0402_1005Metric; LCSC C52923
C9: 33n; C_0402_1005Metric; LCSC C1585; not fitted
C30: 1u; C_0402_1005Metric; LCSC C52923; not fitted
D13, D14, D15, D16, D17, D27: ESD5V0D9B; D_SOD-923; LCSC C484329
R1, R5, R7, R9, R11, R13, R14, R18, R21, R107: 10k; R_0402_1005Metric; LCSC C25744
R3: 61.9; R_0603_1608Metric; LCSC C23092
R4: 10; R_0402_1005Metric; LCSC C25077
R12: 47; R_0402_1005Metric; LCSC C25118
R15: 2.7k; R_0603_1608Metric; LCSC C13167
R17: 30k; R_0603_1608Metric; LCSC C22984
R19, R20: 100k; R_0402_1005Metric; LCSC C25741
R22: 62k; R_0603_1608Metric; LCSC C23221
R24: 22k; R_0402_1005Metric; LCSC C25768
R25: 47k; R_0402_1005Metric; LCSC C25792
R41: 6.8k; R_0402_1005Metric; LCSC C25917
R42, R45: 68k; R_0402_1005Metric; LCSC C36871
R47: 3.3k; R_0402_1005Metric; LCSC C25890
R84: 10k 1%; R_0402_1005Metric; LCSC C25744; not fitted
TP3: Un_Sense; TestPoint_Pad_D1.0mm
TP5: 3xUn; TestPoint_Pad_D1.0mm
TP10: Ip; TestPoint_Pad_D1.0mm
TP11: Rtrim; TestPoint_Pad_D1.0mm
TP12: Vm; TestPoint_Pad_D1.0mm
TP13, TP14: Un; TestPoint_Pad_D1.0mm
TP15: Ip_DAC; TestPoint_Pad_D1.0mm
TP16: Ip_Sense; TestPoint_Pad_D1.0mm
U3, U12: MCP6002T-I/SN; SOIC-8_3.9x4.9mm_P1.27mm; LCSC C7377
U9: GS8332-SR; SOIC-8_3.9x4.9mm_P1.27mm; LCSC C157713
U21: SN74HCS126PWR; TSSOP-14_4.4x5mm_P0.65mm; LCSC C2864468

Connections:
+3.3V: C13.1, C24.1, C25.1, U3.8 (V+), U12.8 (V+), U21.14 (VCC)
GND: C8.2, C11.2, C13.2, C14.2, C24.2, C25.2, C30.2, D13.2 (A2), R5.1, U3.4 (V-), U9.4 (V-), U12.4 (V-), U21.7 (GND)
Ip_dac: R42.1, R107.1, TP15.1
Ip_sense: C11.1, R47.1, TP16.1
LSU_Ip: R3.2, R11.2, TP10.1
LSU_Rtrim: R3.1, R9.2, R12.1, R21.1, TP11.1
LSU_Un: C3.1, R1.1, R22.2, TP13.1
LSU_Vm: C8.1, R4.1, R7.2, R13.1, TP12.1
Nernst_4.2_esr_drive: U21.13 (EN)
Nernst_4.2_esr_drive_O: R41.2, U21.11 (O)
Nernst_4.9_bias: U21.4 (EN), U21.5 (D)
Nernst_4.9_bias_O: R22.1, U21.6 (O)
Nernst_4.9_esr_drive: U21.10 (EN)
Nernst_4.9_esr_drive_O: R24.2, U21.8 (O)
Nernst_ADV_esr_drive: U21.1 (EN)
Nernst_ADV_esr_drive_O: R25.2, U21.3 (O)
Nernst_drive: U21.2 (D), U21.9 (D), U21.12 (D)
unnamed: C3.2, R24.1, R25.1, R41.1
unnamed: C9.1, R12.2, R18.1, U12.7
unnamed: C9.2, R18.2, R42.2, U12.6 (-)
unnamed: C30.1, R4.2, R84.1, U12.1
unnamed: D13.1 (A1), R1.2, U3.5 (+)
unnamed: D14.1 (A1), R7.1, R17.1, U9.6 (-)
unnamed: D15.1 (A1), R11.1, R20.1, U9.3 (+)
unnamed: D16.1 (A1), R9.1, R19.2, U9.2 (-)
unnamed: D17.1 (A1), R13.2, R84.2, U12.2 (-)
unnamed: D27.1 (A1), R21.2, R45.1, U12.5 (+)
unnamed: R14.1, U3.6 (-)
unnamed: R5.2, R15.1, U9.5 (+)
unnamed: R19.1, R47.2, U9.1
unnamed: R20.2, R45.2, R107.2, TP14.1, U3.1, U3.2 (-), U12.3 (+)
Un_3x_sense: R17.2, TP5.1, U9.7
Un_sense: R14.2, R15.2, TP3.1, U3.7
VDDA: C14.1, U9.8 (V+)
Vgnd_ref: U3.3 (+)
~: D14.2 (A2), D15.2 (A2), D16.2 (A2), D17.2 (A2), D27.2 (A2)

Notes on the sheet:
Nernst Sense Voltage Buffer
Ip_sense = 10 * (LSU_Ip - LSU_Rtrim)
caps for 2 x dual opamp
Nernst Sense
Nernst Bias Current
DNI
Pump Current Sense
External Virtual Ground Buffer
Internal Virtual Ground Buffer
Un_3x_sense = 0.247 + 3.15 * (Un - Vm)
Pump Driver
Nernst Internal Resistance Measurement
Zero current while in reset
caps for precision opamp
