tobsec/rusefi-hardware/lambda-x2/untitled.kicad_sch

## KiCad design lambda-x2/untitled.kicad_sch (2024-01-26)

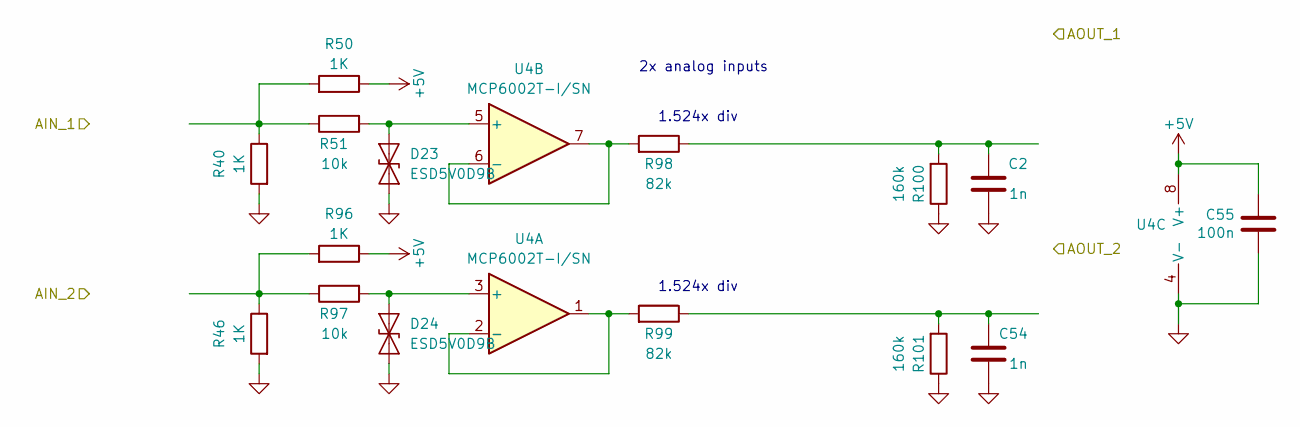
[picture p18: schematic untitled.kicad_sch]

Parts:
C2, C54: 1n; C_0402_1005Metric; LCSC C106205
C55: 100n; C_0402_1005Metric; LCSC C1525
D23, D24: ESD5V0D9B; D_SOD-923; LCSC C484329
R40, R46, R50, R96: 1K; R_0603_1608Metric; LCSC C21190
R51, R97: 10k; R_0402_1005Metric; LCSC C25744
R98, R99: 82k; R_0402_1005Metric; LCSC C325373
R100, R101: 160k; R_0402_1005Metric; LCSC C409854
U4: MCP6002T-I/SN; SOIC-8_3.9x4.9mm_P1.27mm; LCSC C7377

Connections:
+5V: C55.1, R50.1, R96.1, U4.8 (V+)
GND: C2.2, C54.2, C55.2, R40.2, R46.2, R100.1, R101.1, U4.4 (V-)
unnamed: C2.1, R98.1, R100.2
unnamed: C54.1, R99.1, R101.2
unnamed: D23.1 (A1), R51.2, U4.5 (+)
unnamed: D24.1 (A1), R97.2, U4.3 (+)
unnamed: R40.1, R50.2, R51.1
unnamed: R46.1, R96.2, R97.1
unnamed: R98.2, U4.6 (-), U4.7
unnamed: R99.2, U4.1, U4.2 (-)
~: D23.2 (A2), D24.2 (A2)

Notes on the sheet:
2x analog inputs
1.524x div
