tobsec/rusefi-hardware/(commit log)

2024-01-26 First version for lambda-x2 based on rev1
    [analog.kicad_sch, egt.kicad_sch, lambda-x2.kicad_sch, lsu.kicad_sch, untitled.kicad_sch]
2024-02-21 Further updates for Rev2
    [analog.kicad_sch, bom.csv, designators.csv, egt-prot.kicad_sch, egt.kicad_sch, lambda-x2.kicad_sch, lsu.kicad_sch, positions.csv]
2024-03-16 minor rework
    [bom.csv, lambda-x2.kicad_sch, positions.csv]
